DodoZimmermann/lamp-2/Hardware/Electrical/PCB_v2/Images/JLCPCB stackup and trace width.jpg

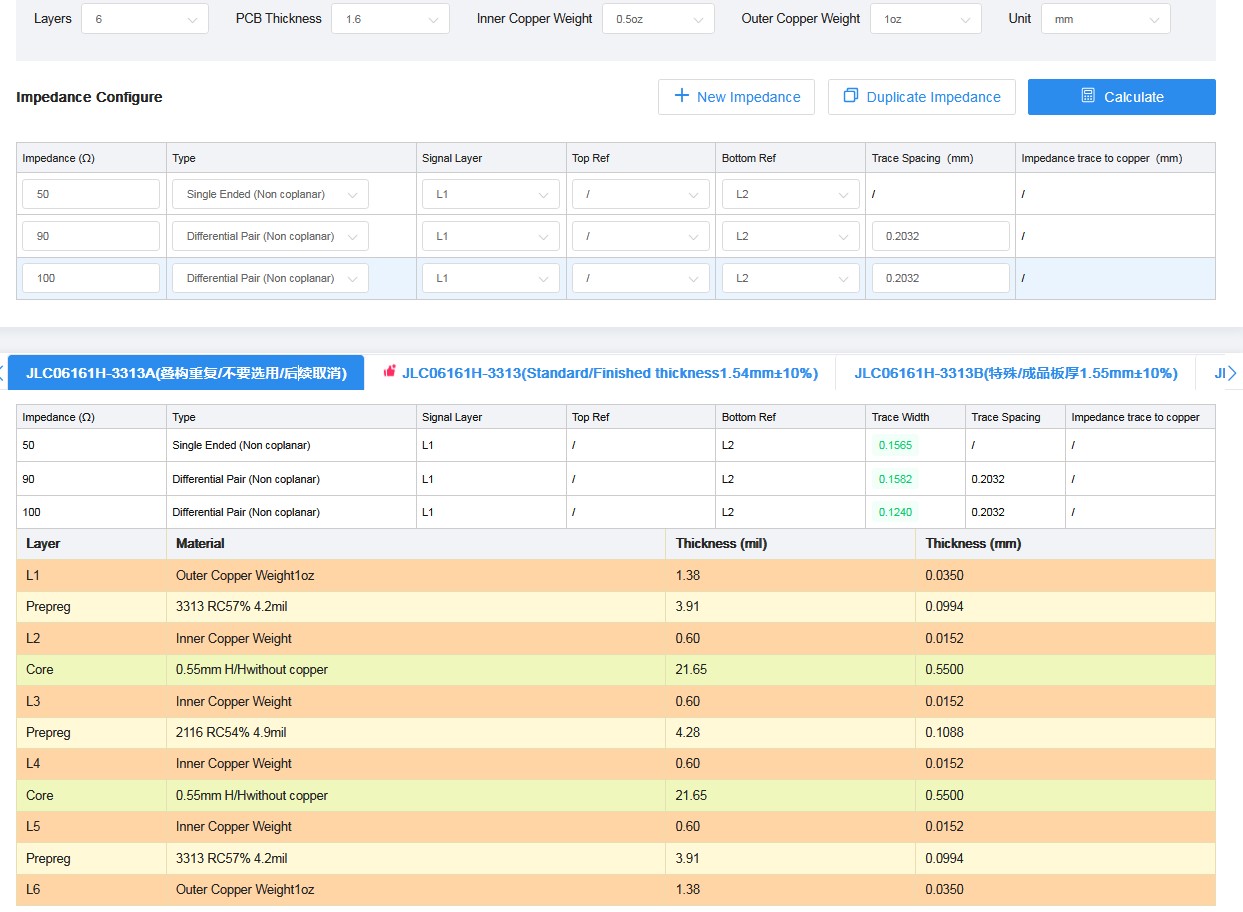
Hardware/Electrical/PCB_v2/Images/JLCPCB stackup and trace width.jpg
