DodoZimmermann/lamp-2/Hardware/Electrical/PCB_v2/Images/LED_Grid.png

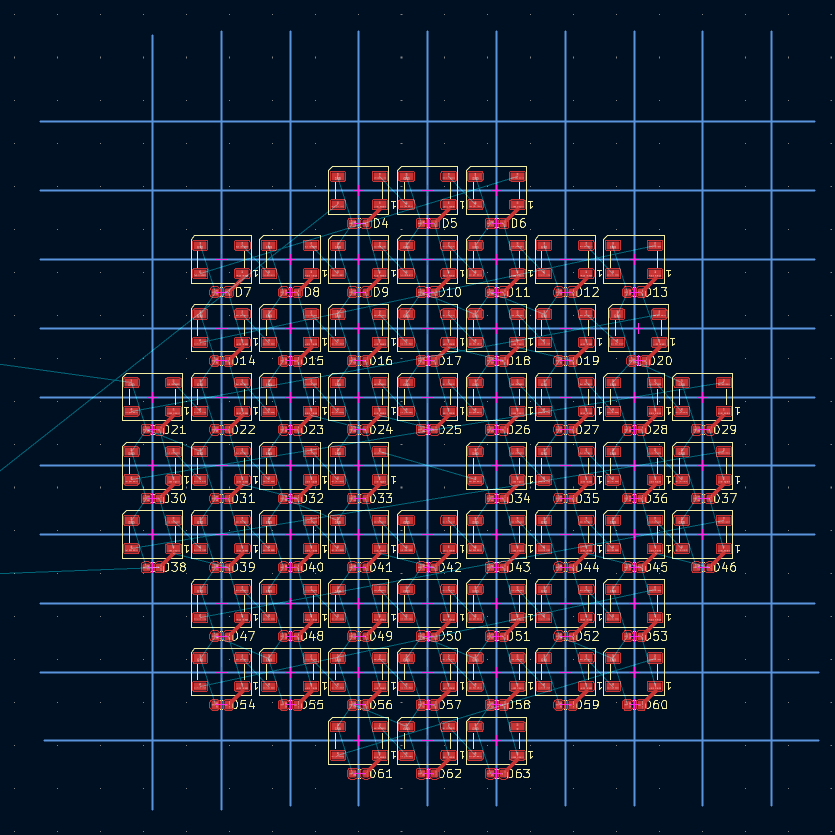
Hardware/Electrical/PCB_v2/Images/LED_Grid.png
