DodoZimmermann/lamp-2/Hardware/Electrical/Parts List.xlsx

Description | Supplier | Supplier Part Nr | Manufacturer | Manufacturer Part Nr | Price | Amount | Total price
Li-ion Cell 18650 3300mAh | Conrad | 1558872 - 62 | Panasonic | NCR18650GA | CHF 4.95 | 4 | CHF 19.80
