DodoZimmermann/lamp-2/Hardware/Electrical/PCB_Outline.dxf

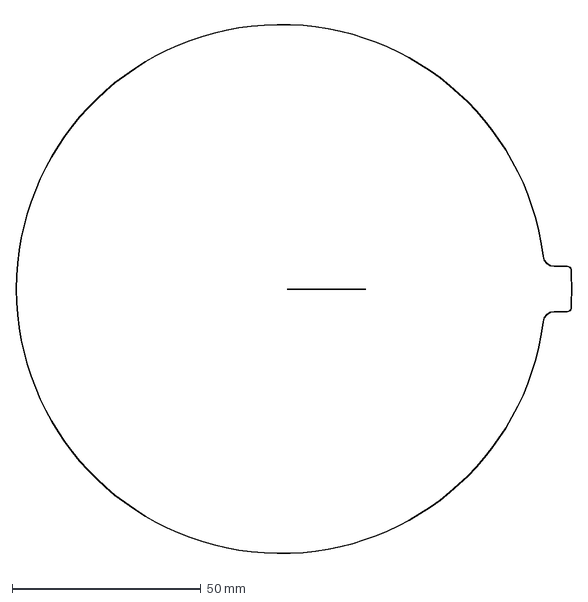
[picture p3: CAD file, 2026-04-02]
Hardware/Electrical/PCB_Outline.dxf
147.0 x 144.3 mm
