DodoZimmermann/lamp-2/Hardware/Electrical/PCB_v2/lamp_PCBv2.step

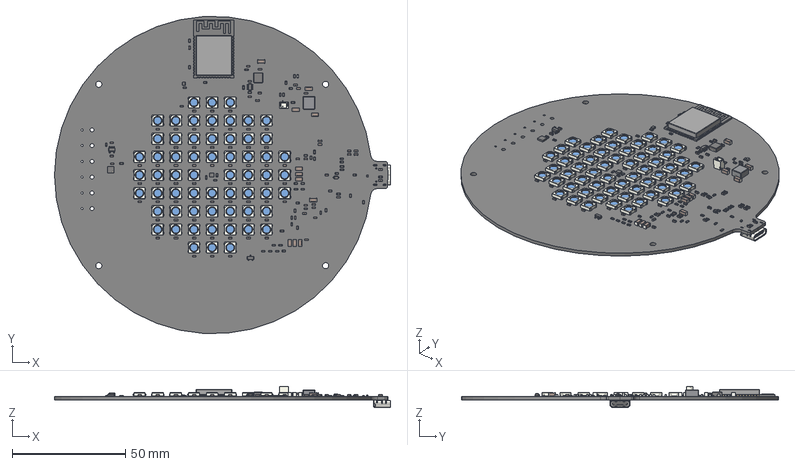
[picture p4: CAD file, 2026-06-07]
Hardware/Electrical/PCB_v2/lamp_PCBv2.step
148.2 x 139.7 x 9.27 mm
C_0603_1608Metric x 93
R_0603_1608Metric x 52
C_1206_3216Metric x 11
LED_WS2812B_PLCC4_5.0x5.0mm_P3.2mm x 60
WSON-8-1EP_2x2mm_P0.5mm_EP0.9x1.6mm
SOT-23
SOT-563
SOT-23-6
SOT-23-5
DFN-10-1EP_3x3mm_P0.5mm_EP1.55x2.48mm
Texas_DRT-3
LED_0603_1608Metric
ESP32-S3-WROOM-1
L_Bourns_SRP5030T
D_SOD-323
L_Pulse_PA5402
JST_SH_BM02B-SRSS-TB_1x02-1MP_P1.00mm_Vertical
USB_C_Receptacle_GCT_USB4105-xx-A_16P_TopMnt_Horizontal
PCB_v2_PCB_1
PCB_v2_PCB_2
