DodoZimmermann/lamp-2/Hardware/Mechanical/LampBall_Gross.step

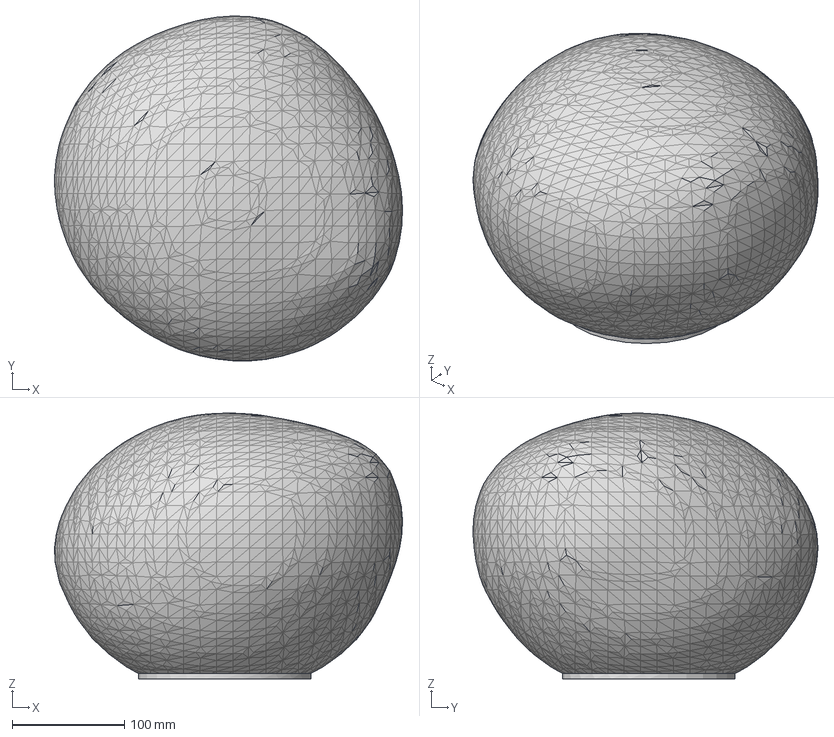
[picture p5: CAD file, 2026-04-02]
Hardware/Mechanical/LampBall_Gross.step
310.6 x 307.8 x 237.2 mm
