DodoZimmermann/lamp-2/Hardware/Mechanical/LampBall.stl

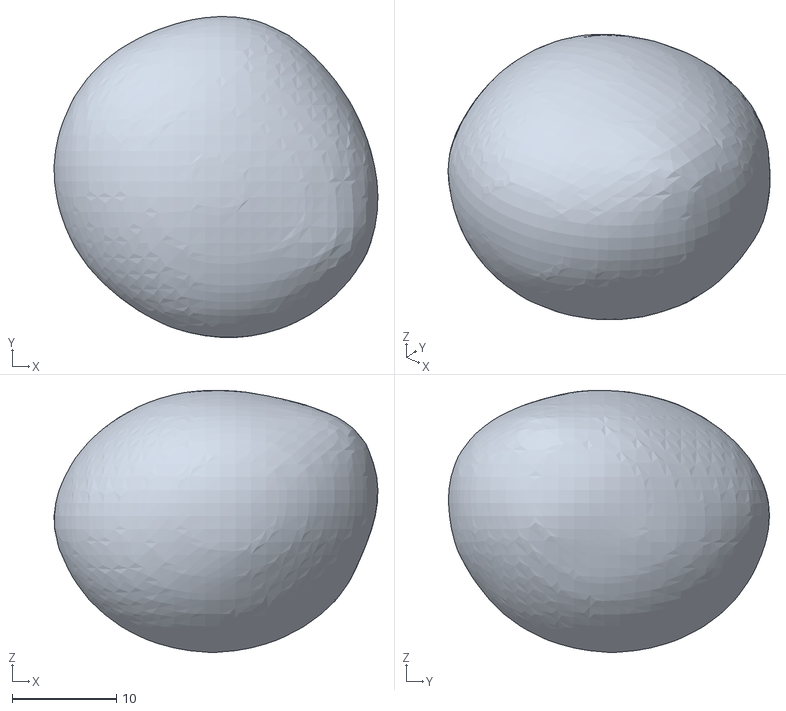
[picture p6: CAD file, 2026-04-02]
Hardware/Mechanical/LampBall.stl
31.1 x 30.8 x 25.2
