DodoZimmermann/lamp-2/Hardware/Electrical/PCB/Extra-devices/BQ24600RVAR/BQ24600RVAR.step

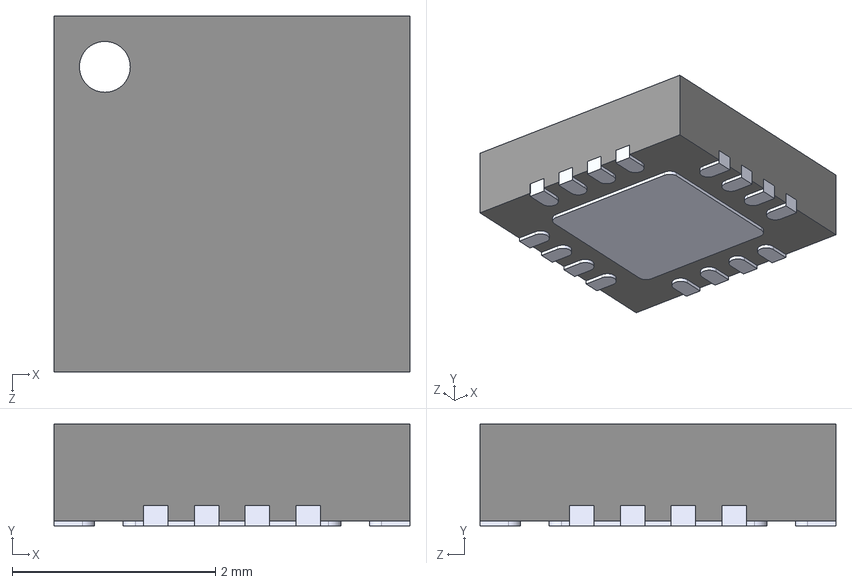
[picture p7: CAD file, 2026-03-09, an earlier design]
Hardware/Electrical/PCB/Extra-devices/BQ24600RVAR/BQ24600RVAR.step
3.50 x 1.00 x 3.50 mm
