DodoZimmermann/lamp-2/(list of files, cad)

Other CAD files:
Hardware/Mechanical/LampBall.blend
Hardware/Mechanical/LampBall.f3d
