DodoZimmermann/lamp-2/Hardware/Electrical/PCB_v2/PCB_v2.kicad_pcb

## KiCad design Hardware/Electrical/PCB_v2/PCB_v2.kicad_pcb (2026-06-07)

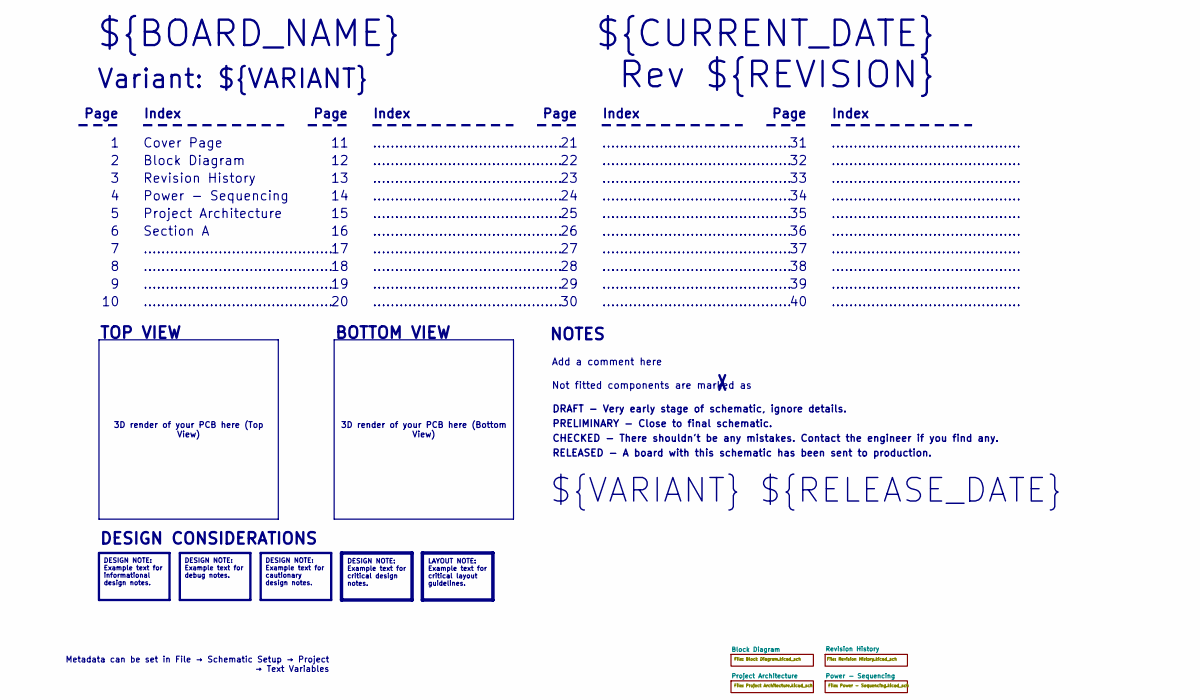
[picture p8: schematic PCB_v2.kicad_sch, Cover Page]

Notes on the sheet:
BOTTOM VIEW
...........................................
RELEASED - A board with this schematic has been sent to production.
Page
TOP VIEW
Not fitted components are marked as
Index
PRELIMINARY - Close to final schematic.
${VARIANT} ${RELEASE_DATE}
Power - Sequencing
${CURRENT_DATE}
Variant: ${VARIANT}
Rev ${REVISION}
Project Architecture
${BOARD_NAME}
DRAFT - Very early stage of schematic, ignore details.
Section A
Block Diagram
Add a comment here
Cover Page
NOTES
Revision History
CHECKED - There shouldn't be any mistakes. Contact the engineer if you find any.
DESIGN CONSIDERATIONS
3D render of your PCB here (Bottom View)
3D render of your PCB here (Top View)
Metadata can be set in File → Schematic Setup → Project → Text Variables
DESIGN NOTE: Example text for informational design notes.
LAYOUT NOTE: Example text for critical layout guidelines.
DESIGN NOTE: Example text for cautionary design notes.
DESIGN NOTE: Example text for debug notes.
DESIGN NOTE: Example text for critical design notes.

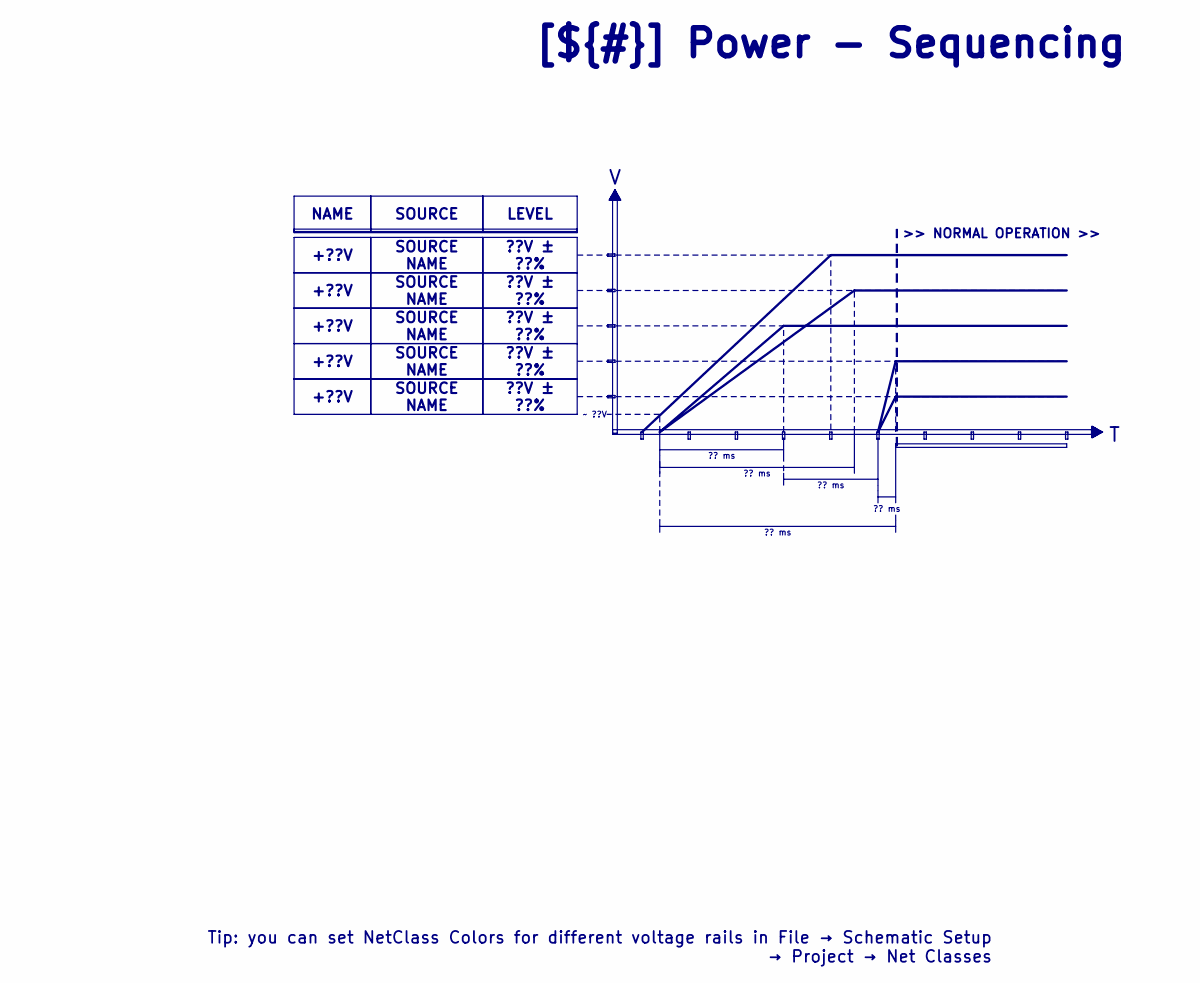
[picture p9: schematic Power - Sequencing.kicad_sch]

Notes on the sheet:
>> NORMAL OPERATION >>
LEVEL
+??V
SOURCE NAME
?? ms
??V ± ??%
[${#}] ${TITLE}
~ ??V
NAME
SOURCE
Tip: you can set NetClass Colors for different voltage rails in File → Schematic Setup → Project → Net Classes

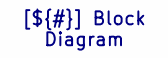
[picture p10: schematic Block Diagram.kicad_sch]

Notes on the sheet:
[${#}] ${TITLE}


Notes on the sheet:
- _________________________________ - _________________________________ - _________________________________ - _________________________________ - _________________________________ - _________________________________ - _________________________________ - _________________________________ - _________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
DD.MM.YYYY - xxx Revision Variant: xxx
[${#}] ${TITLE}

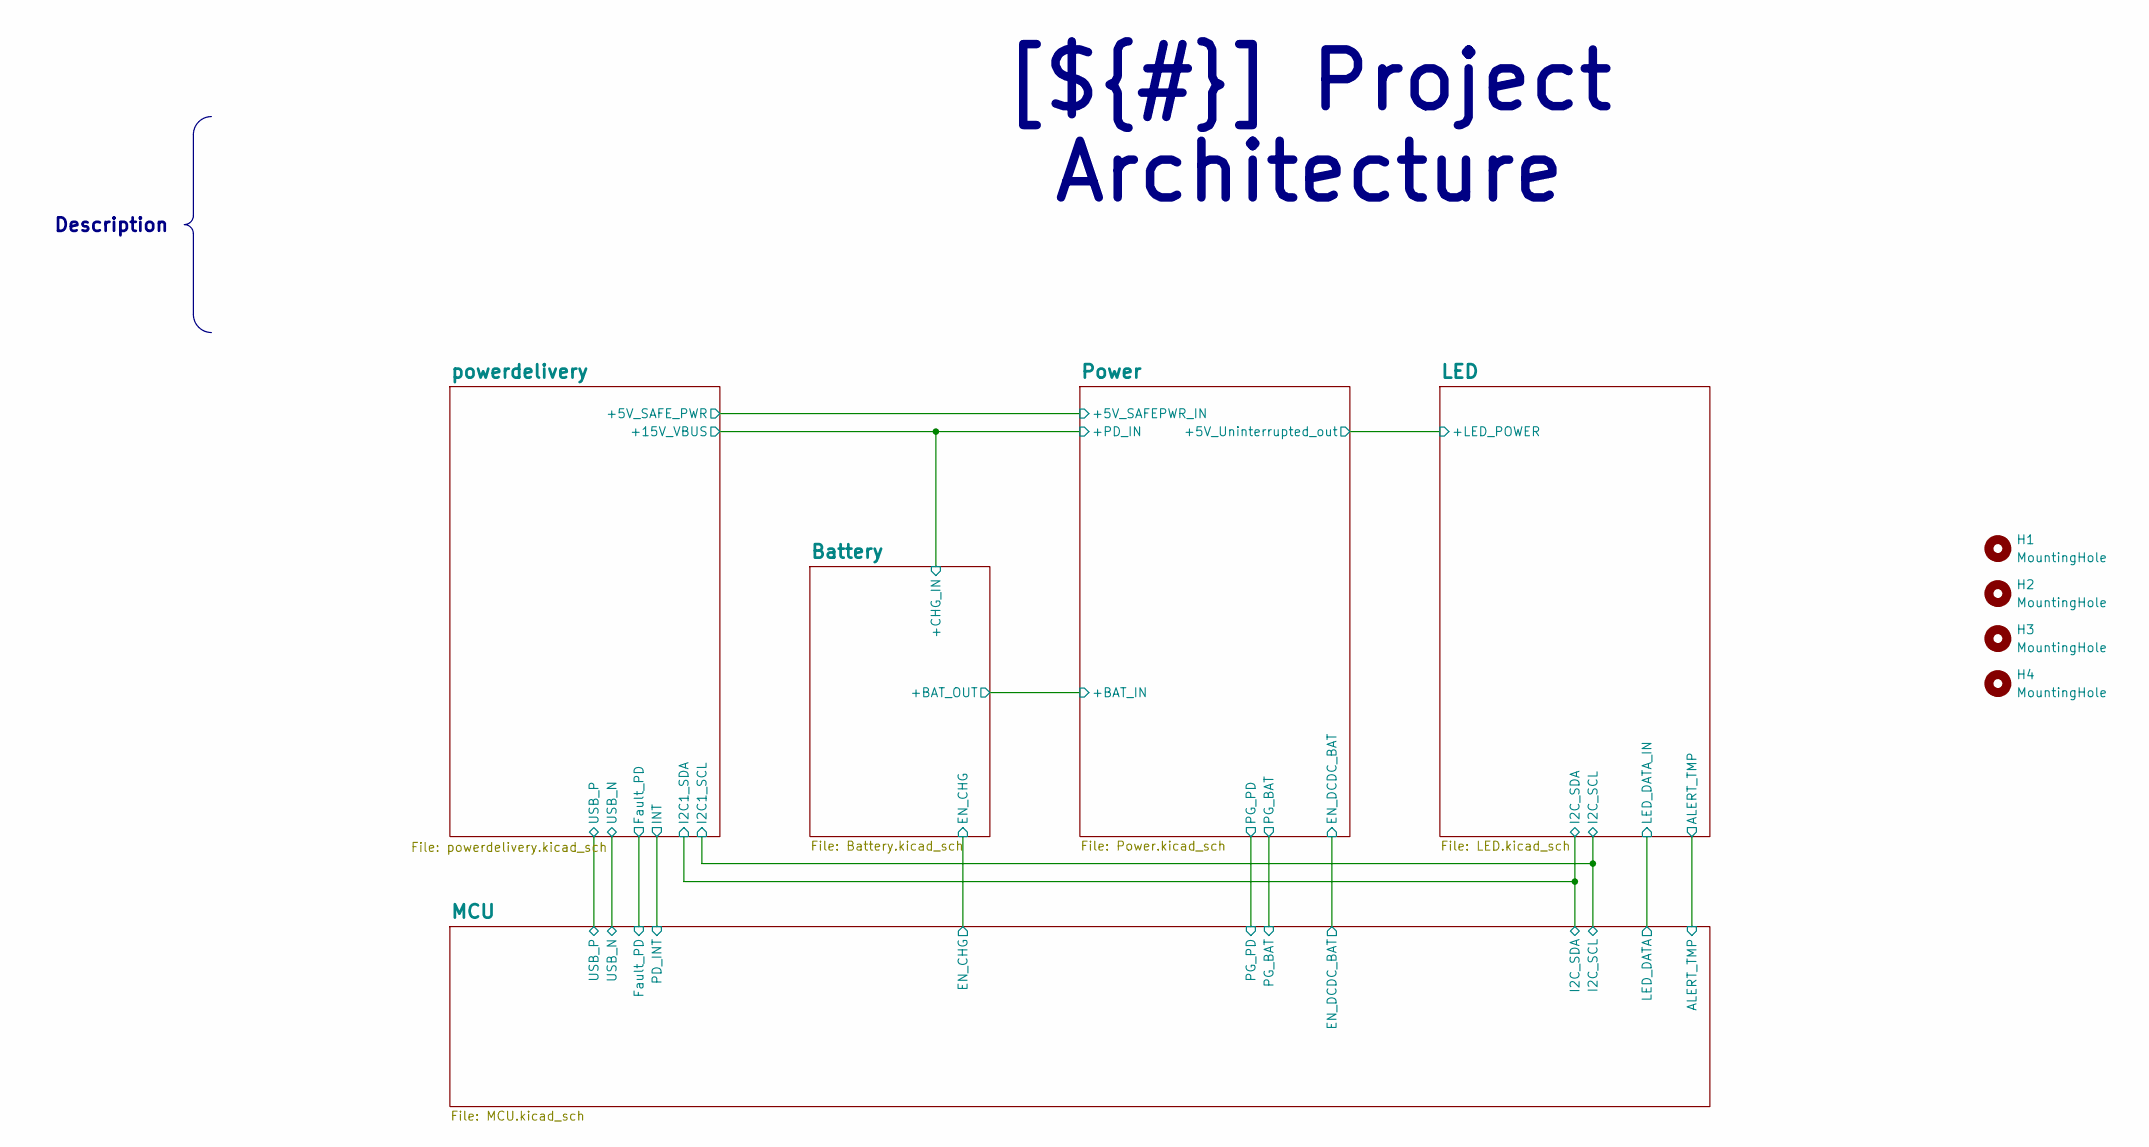
[picture p12: schematic Project Architecture.kicad_sch]

Parts:
H1, H2, H3, H4: MountingHole; MountingHole_2.7mm_M2.5

Notes on the sheet:
Description
[${#}] ${TITLE}

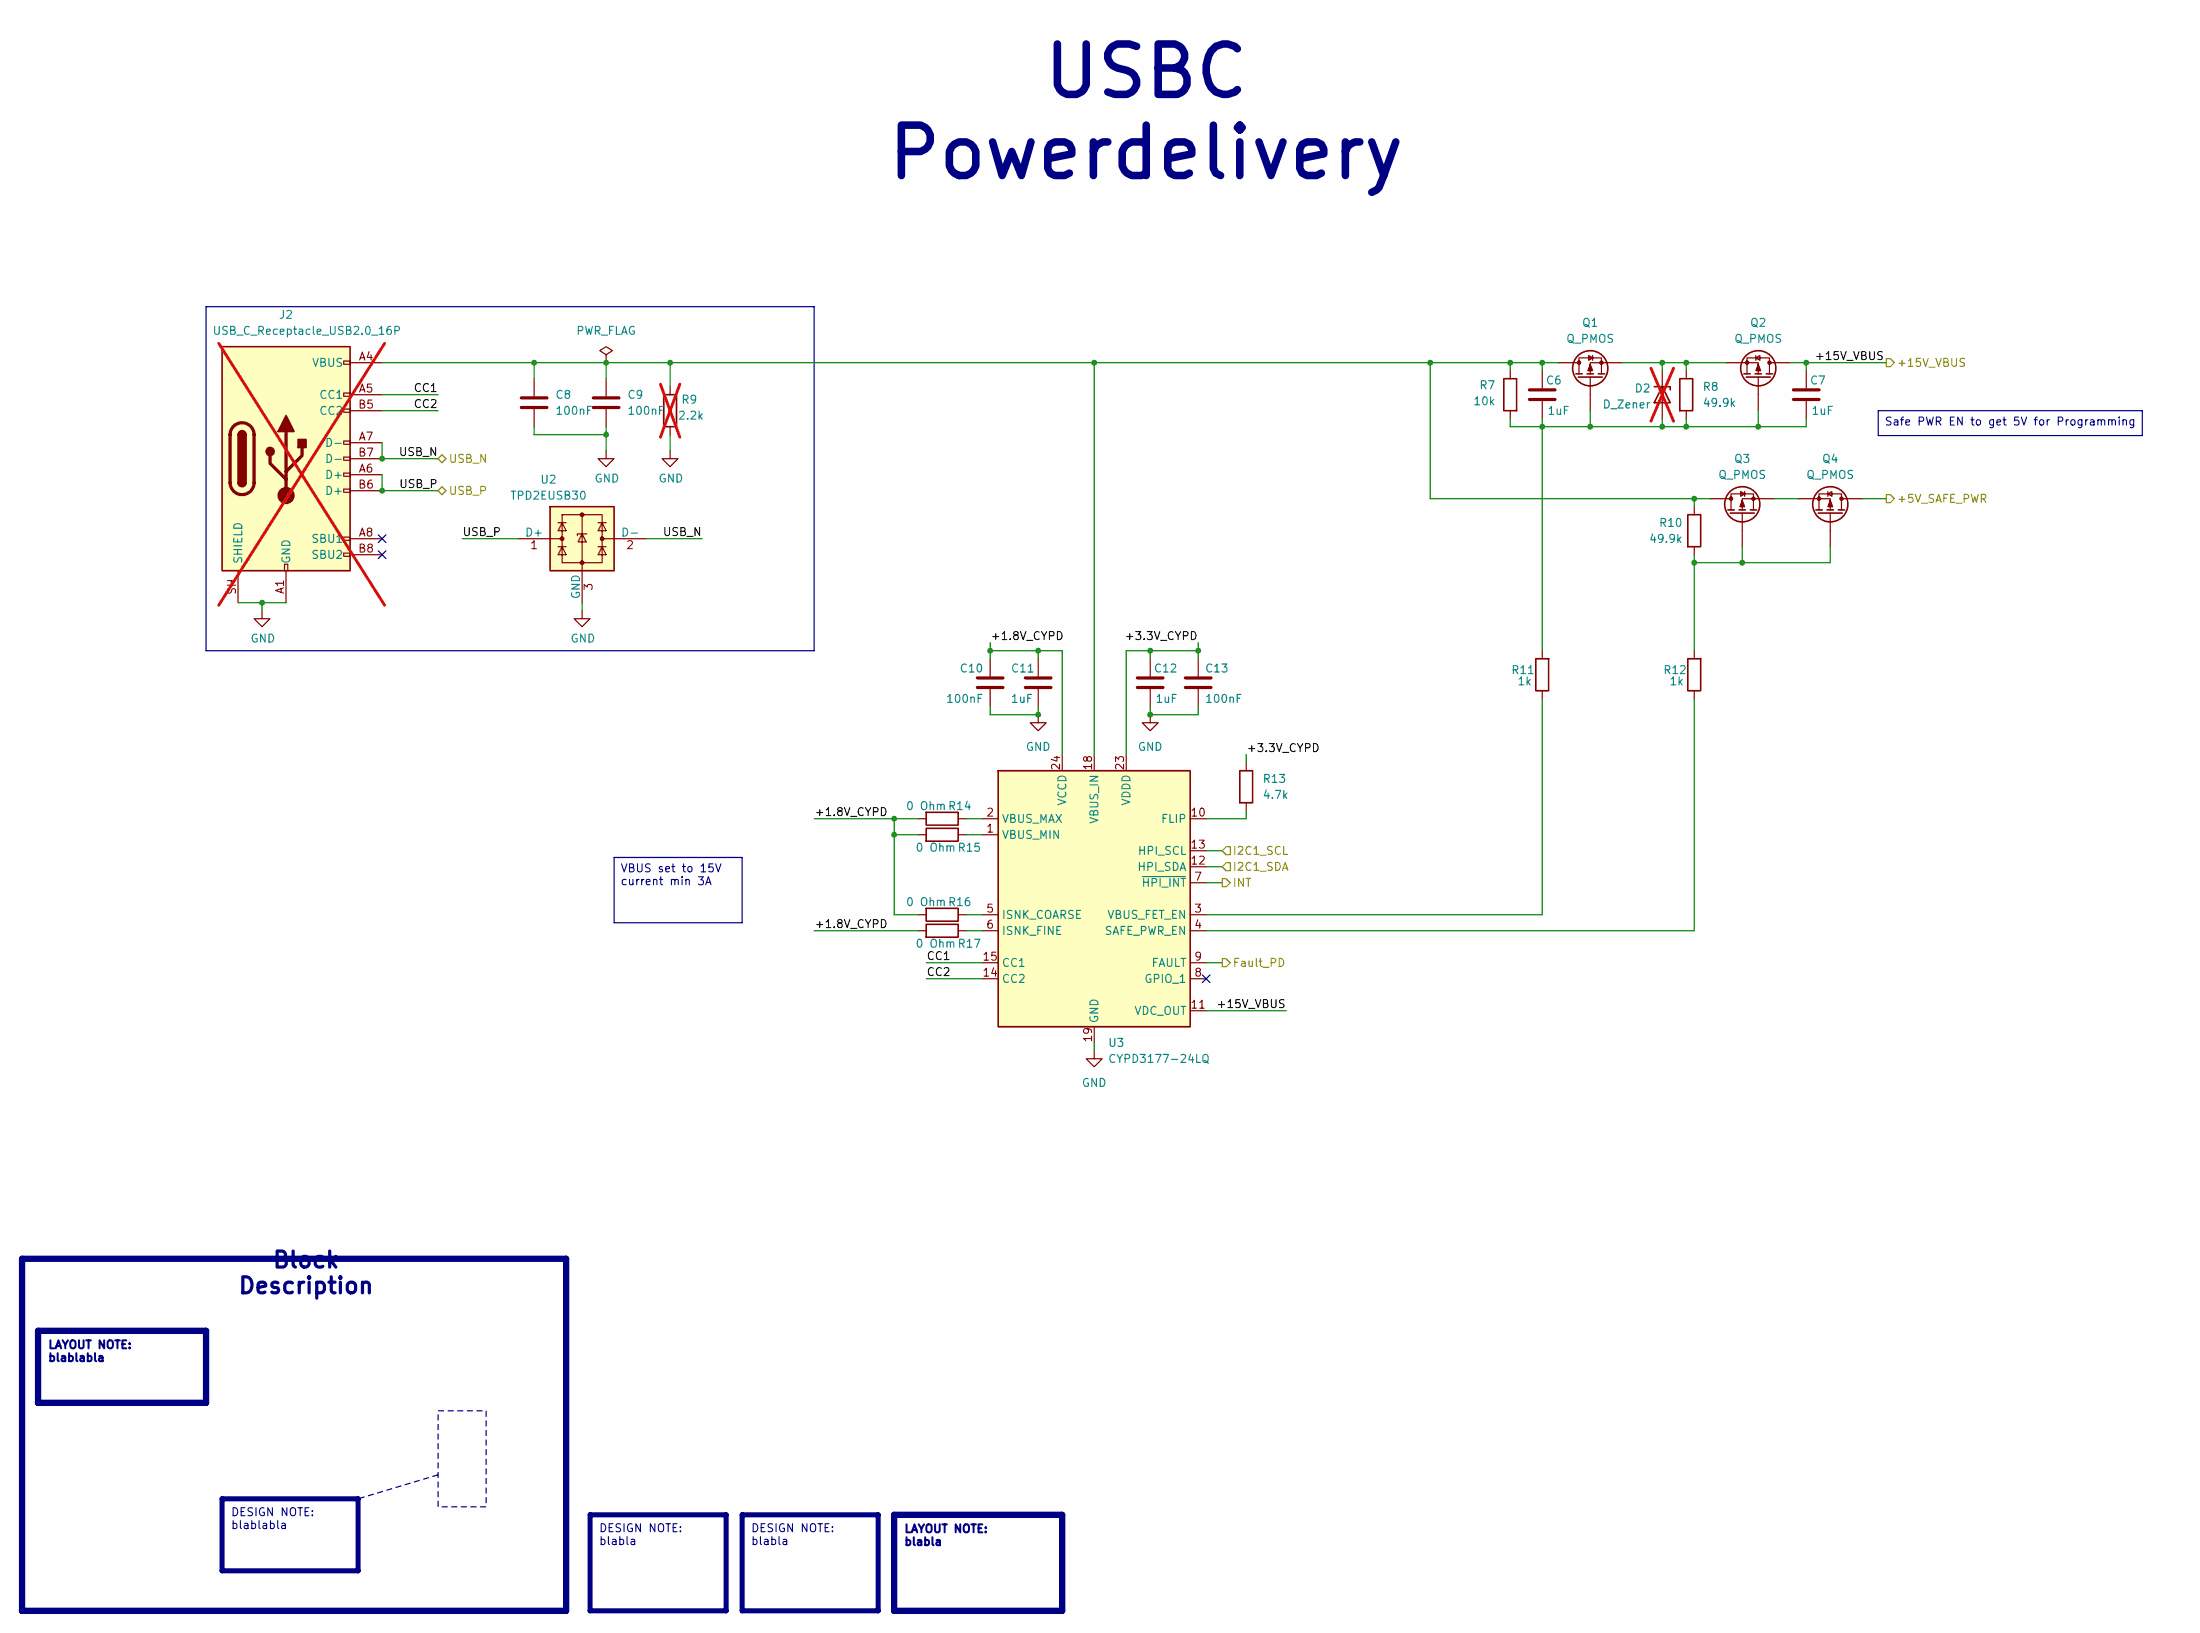
[picture p13: schematic powerdelivery.kicad_sch, Sheet Title A]

Parts:
C6, C7, C11, C12: 1uF; C_0603_1608Metric; Manufacturer Part Number CC0603KRX7R9BB105; LCSC Part # C15849
C8, C9, C10, C13: 100nF; C_0603_1608Metric; Manufacturer Part Number 885012206095; LCSC Part # C14663
D2: D_Zener; D_SOD-323; not fitted
J2: USB_C_Receptacle_USB2.0_16P; USB_C_Receptacle_GCT_USB4105-xx-A_16P_TopMnt_Horizontal; Manufacturer Part Number USB4105-GF-A; not fitted
Q1, Q2, Q3, Q4: Q_PMOS; PowerPAK_SO-8; Manufacturer Part Number SI7149ADP-T1-GE3; LCSC Part # C554002
R7: 10k; R_0603_1608Metric; Manufacturer Part Number ERJ-PB3B1002V; LCSC Part # C25804
R8, R10: 49.9k; R_0603_1608Metric; LCSC Part # C23184
R9: 2.2k; R_0603_1608Metric; Manufacturer Part Number RC0603FR-072K2L; LCSC Part # C114662; not fitted
R11, R12: 1k; R_0603_1608Metric; Manufacturer Part Number RC0603FR-071KL; LCSC Part # C21190
R13: 4.7k; R_0603_1608Metric; LCSC Part # C23162
R14, R15, R16, R17: 0 Ohm; R_0603_1608Metric; Manufacturer Part Number RC0603JR-070RL; LCSC Part # C21189
U2: TPD2EUSB30; Texas_DRT-3; Manufacturer Part Number TPD2EUSB30ADRTR; LCSC Part # C97502
U3: CYPD3177-24LQ; QFN-24-1EP_4x4mm_P0.5mm_EP2.75x2.75mm; LCSC Part # C2959321

Connections:
/Project Architecture/LED/I2C_SCL: U3.13 (HPI_SCL); also elsewhere on the board
/Project Architecture/LED/I2C_SDA: U3.12 (HPI_SDA); also elsewhere on the board
/Project Architecture/MCU/Fault_PD: U3.9 (FAULT); also elsewhere on the board
/Project Architecture/MCU/PD_INT: U3.7 (~HPI_INT); also elsewhere on the board
/Project Architecture/Power/+5V_SAFEPWR_IN: Q4.D; also elsewhere on the board
/Project Architecture/powerdelivery/+1.8V_CYPD: C10.2, C11.2, R14.2, R15.2, R16.2, R17.2, U3.24 (VCCD)
/Project Architecture/powerdelivery/+3.3V_CYPD: C12.2, C13.2, R13.1, U3.23 (VDDD)
/Project Architecture/powerdelivery/+15V_VBUS: C7.2, Q2.D, U3.11 (VDC_OUT); also elsewhere on the board
/Project Architecture/powerdelivery/CC1: J2.A5 (CC1), U3.15 (CC1)
/Project Architecture/powerdelivery/CC2: J2.B5 (CC2), U3.14 (CC2)
/Project Architecture/powerdelivery/USB_N: J2.A7 (D-), J2.B7 (D-), U2.2 (D-); also elsewhere on the board
/Project Architecture/powerdelivery/USB_P: J2.A6 (D+), J2.B6 (D+), U2.1 (D+); also elsewhere on the board
GND: C8.1, C9.1, C10.1, C11.1, C12.1, C13.1, J2.A1 (GND), J2.A12 (GND), J2.B1 (GND), J2.B12 (GND), J2.SH (SHIELD), R9.1, U2.3 (GND), U3.19 (GND), U3.22 (GND), U3.25 (GND); also elsewhere on the board
unnamed: C6.1, C7.1, D2.2 (A), Q1.G, Q2.G, R7.2, R8.2, R11.2
unnamed: D2.1 (K), Q1.S, Q2.S, R8.1
unnamed: Q3.G, Q4.G, R10.2, R12.2
unnamed: Q3.S, Q4.S
unnamed: R13.2, U3.10 (FLIP)
unnamed: R16.1, U3.5 (ISNK_COARSE)
unnamed: R17.1, U3.6 (ISNK_FINE)
unnamed: R12.1, U3.4 (SAFE_PWR_EN)
unnamed: R11.1, U3.3 (VBUS_FET_EN)
unnamed: C6.2, C8.2, C9.2, J2.A4 (VBUS), J2.A9 (VBUS), J2.B4 (VBUS), J2.B9 (VBUS), Q1.D, Q3.D, R7.1, R9.2, R10.1, U3.18 (VBUS_IN)
unnamed: R14.1, U3.2 (VBUS_MAX)
unnamed: R15.1, U3.1 (VBUS_MIN)

Notes on the sheet:
Block Description
DESIGN NOTE: blabla
LAYOUT NOTE: blablabla
USBC Powerdelivery
LAYOUT NOTE: blabla
Safe PWR EN to get 5V for Programming
DESIGN NOTE: blablabla
VBUS set to 15V current min 3A

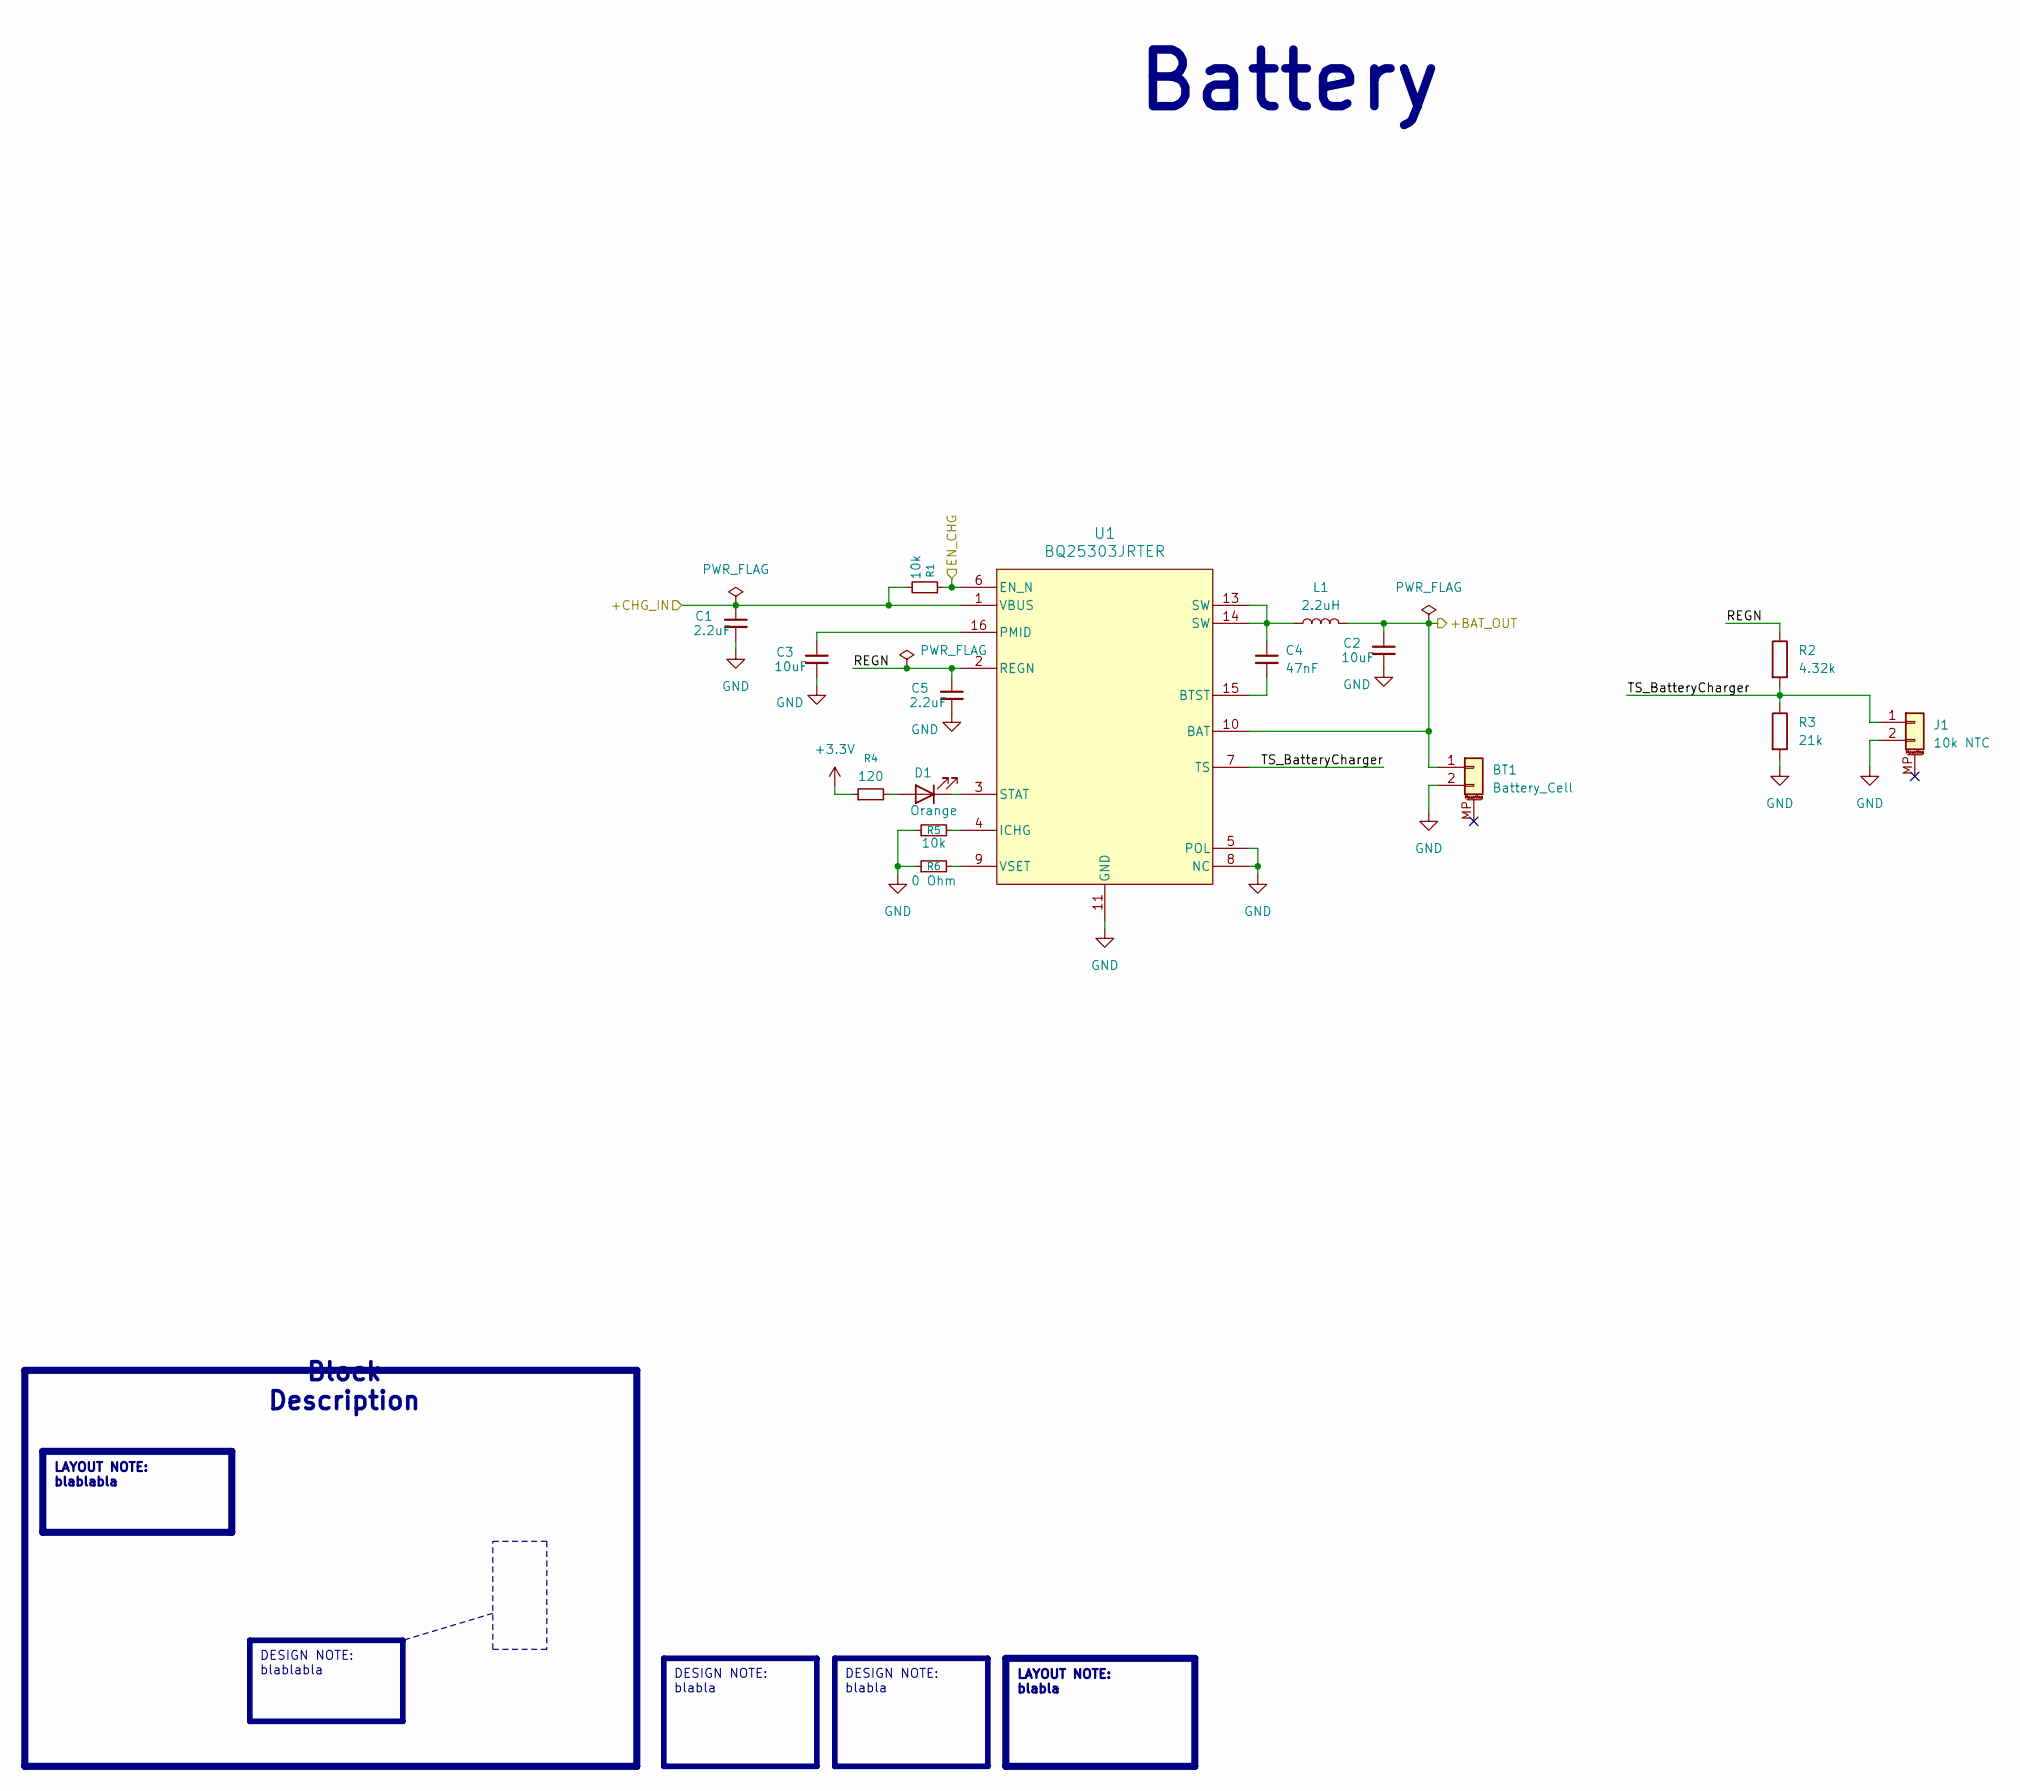
[picture p14: schematic Battery.kicad_sch, Sheet Title A]

Parts:
BT1: Battery_Cell; Molex_Micro-Fit_3.0_43650-0224_1x02-1MP_P3.00mm_Vertical; LCSC Part # C122425
C1, C5: 2.2uF; C_0603_1608Metric; LCSC Part # C23630
C2, C3: 10uF; C_1206_3216Metric; LCSC Part # C13585
C4: 47nF; C_0603_1608Metric; LCSC Part # C1622
D1: Orange; LED_0603_1608Metric; LCSC Part # C2286
J1: 10k NTC; JST_SH_BM02B-SRSS-TB_1x02-1MP_P1.00mm_Vertical; LCSC Part # C160388
L1: 2.2uH; L_Bourns_SRP5030T; LCSC Part # C2847475
R1, R5: 10k; R_0603_1608Metric; LCSC Part # C25804
R2: 4.32k; R_0603_1608Metric; LCSC Part # C23158
R3: 21k; R_0603_1608Metric; LCSC Part # C137769
R4: 120; R_0603_1608Metric; LCSC Part # C22765
R6: 0 Ohm; R_0603_1608Metric; LCSC Part # C21189
U1: BQ25303JRTER; WQFN-16-1EP_3x3mm_P0.5mm_EP1.68x1.68mm; LCSC Part # C2842775

Connections:
+3.3V: R4.1; also elsewhere on the board
/Project Architecture/Battery/+BAT_OUT: BT1.1, C2.1, L1.2, U1.10 (BAT); also elsewhere on the board
/Project Architecture/Battery/EN_CHG: R1.1, U1.6 (EN_N); also elsewhere on the board
/Project Architecture/Battery/REGN: C5.1, R2.1, U1.2 (REGN)
/Project Architecture/Battery/TS_BatteryCharger: J1.1, R2.2, R3.1, U1.7 (TS)
/Project Architecture/powerdelivery/+15V_VBUS: C1.1, R1.2, U1.1 (VBUS); also elsewhere on the board
GND: BT1.2, C1.2, C2.2, C3.2, C5.2, J1.2, R3.2, R5.1, R6.1, U1.5 (POL), U1.8 (NC), U1.11 (GND), U1.12 (GND), U1.17 (PAD); also elsewhere on the board
unnamed: C4.1, L1.1, U1.13 (SW), U1.14 (SW)
unnamed: D1.2 (A), R4.2
unnamed: D1.1 (K), U1.3 (STAT)
unnamed: C4.2, U1.15 (BTST)
unnamed: R5.2, U1.4 (ICHG)
unnamed: C3.1, U1.16 (PMID)
unnamed: R6.2, U1.9 (VSET)

Notes on the sheet:
Battery
LAYOUT NOTE: blablabla
DESIGN NOTE: blabla
Block Description
LAYOUT NOTE: blabla
DESIGN NOTE: blablabla

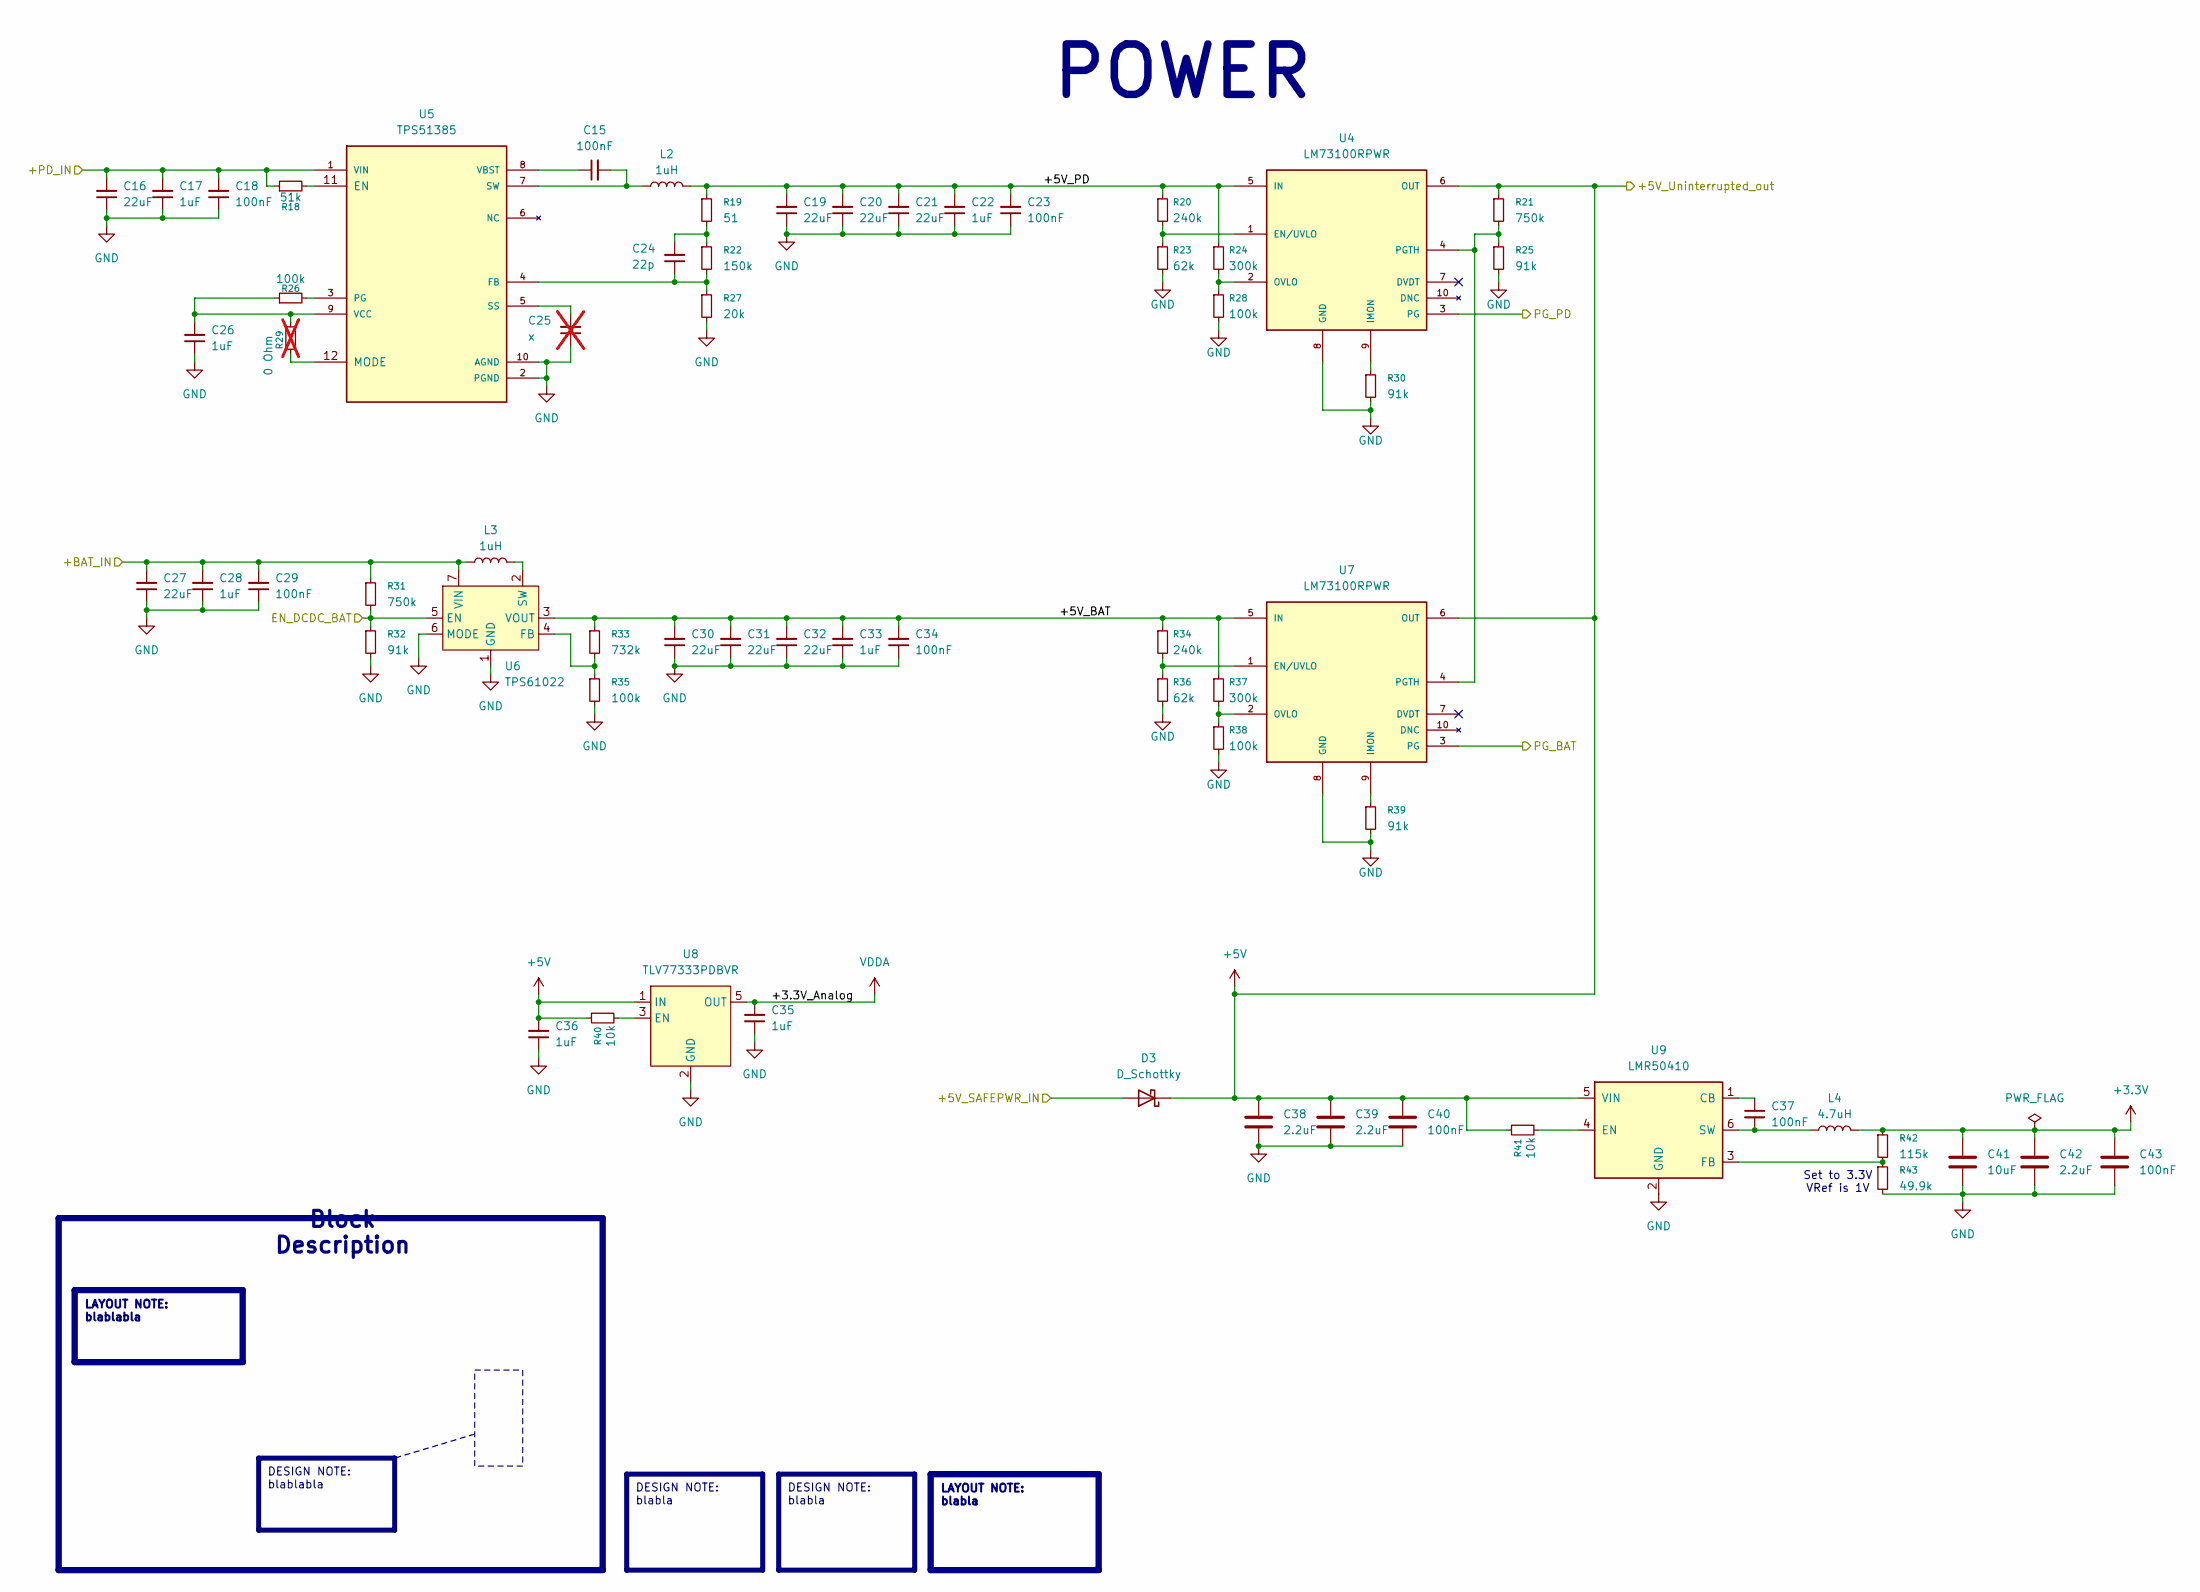
[picture p15: schematic Power.kicad_sch, Sheet Title A]

Parts:
C15, C18, C23, C29, C34, C37, C40, C43: 100nF; C_0603_1608Metric; LCSC Part # C14663
C16, C19, C20, C21, C27, C30, C31, C32: 22uF; C_1206_3216Metric; LCSC Part # C12891
C17, C22, C26, C28, C33, C35, C36: 1uF; C_0603_1608Metric; LCSC Part # C15849
C24: 22p; C_0603_1608Metric; LCSC Part # C1653
C25: x; C_0603_1608Metric; not fitted
C38, C39, C42: 2.2uF; C_0603_1608Metric; LCSC Part # C23630
C41: 10uF; C_1206_3216Metric; LCSC Part # C13585
D3: D_Schottky; SOT-23; LCSC Part # C2135
L2, L3: 1uH; L_Bourns_SRP7028A_7.3x6.6mm; LCSC Part # C2847480
L4: 4.7uH; L_Pulse_PA5402; LCSC Part # C553980
R18: 51k; R_0603_1608Metric; LCSC Part # C23196
R19: 51; R_0603_1608Metric; LCSC Part # C23197
R20, R34: 240k; R_0603_1608Metric; LCSC Part # C137765
R21, R31: 750k; R_0603_1608Metric; LCSC Part # C137684
R22: 150k; R_0603_1608Metric; LCSC Part # C22807
R23, R36: 62k; R_0603_1608Metric; LCSC Part # C137694
R24, R37: 300k; R_0603_1608Metric; LCSC Part # C23024
R25, R30, R32, R39: 91k; R_0603_1608Metric; LCSC Part # C23265
R26, R28, R35, R38: 100k; R_0603_1608Metric; LCSC Part # C25803
R27: 20k; R_0603_1608Metric; LCSC Part # C4184
R29: 0 Ohm; R_0603_1608Metric; not fitted
R33: 732k; R_0603_1608Metric; LCSC Part # C246003
R40, R41: 10k; R_0603_1608Metric; LCSC Part # C25804
R42: 115k; R_0603_1608Metric; LCSC Part # C22783
R43: 49.9k; R_0603_1608Metric; LCSC Part # C23184
U4, U7: LM73100RPWR; IC_LM73100RPWR; PARTREV 08/2019; LCSC Part # C3210761
U5: TPS51385; VREG_TPS51386RJNR; LCSC Part # C22418767
U6: TPS61022; Texas_RWU0007A_VQFN-7_2x2mm_P0.5mm; LCSC Part # C915088
U8: TLV77333PDBVR; SOT-23-5; LCSC C32445874
U9: LMR50410; SOT-23-6; LCSC Part # C2841056

Connections:
+3.3V: C41.1, C42.1, C43.1, L4.2, R42.1; also elsewhere on the board
+5V: C36.2, C38.1, C39.1, C40.1, D3.3 (K), R21.1, R40.1, R41.1, U4.6 (OUT), U7.6 (OUT), U8.1 (IN), U9.5 (VIN); also elsewhere on the board
/Project Architecture/Battery/+BAT_OUT: C27.2, C28.2, C29.2, L3.1, R31.1, U6.7 (VIN); also elsewhere on the board
/Project Architecture/MCU/EN_DCDC_BAT: R31.2, R32.1, U6.5 (EN); also elsewhere on the board
/Project Architecture/MCU/PG_BAT: U7.3 (PG); also elsewhere on the board
/Project Architecture/MCU/PG_PD: U4.3 (PG); also elsewhere on the board
/Project Architecture/Power/+5V_BAT: C30.2, C31.2, C32.2, C33.2, C34.2, R33.1, R34.1, R37.1, U6.3 (VOUT), U7.5 (IN)
/Project Architecture/Power/+5V_PD: C19.2, C20.2, C21.2, C22.2, C23.2, L2.2, R19.1, R20.1, R24.1, U4.5 (IN)
/Project Architecture/Power/+5V_SAFEPWR_IN: D3.1 (A), D3.2 (A); also elsewhere on the board
/Project Architecture/powerdelivery/+15V_VBUS: C16.2, C17.2, C18.2, R18.1, U5.1 (VIN); also elsewhere on the board
GND: C16.1, C17.1, C18.1, C19.1, C20.1, C21.1, C22.1, C23.1, C25.1, C26.1, C27.1, C28.1, C29.1, C30.1, C31.1, C32.1, C33.1, C34.1, C35.1, C36.1, C38.2, C39.2, C40.2, C41.2, C42.2, C43.2, R23.2, R25.2, R27.2, R28.2, R30.2, R32.2, R35.2, R36.2, R38.2, R39.2, R43.2, U4.8 (GND), U5.2 (PGND), U5.10 (AGND), U6.1 (GND), U6.6 (MODE), U7.8 (GND), U8.2 (GND), U8.4 (NC), U9.2 (GND); also elsewhere on the board
unnamed: C24.2, R19.2, R22.1
unnamed: R20.2, R23.1, U4.1 (EN/UVLO)
unnamed: R30.1, U4.9 (IMON)
unnamed: R24.2, R28.1, U4.2 (OVLO)
unnamed: R21.2, R25.1, U4.4 (PGTH), U7.4 (PGTH)
unnamed: R18.2, U5.11 (EN)
unnamed: C24.1, R22.2, R27.1, U5.4 (FB)
unnamed: R29.1, U5.12 (MODE)
unnamed: R26.2, U5.3 (PG)
unnamed: C25.2, U5.5 (SS)
unnamed: C15.2, L2.1, U5.7 (SW)
unnamed: C15.1, U5.8 (VBST)
unnamed: C26.2, R26.1, R29.2, U5.9 (VCC)
unnamed: R33.2, R35.1, U6.4 (FB)
unnamed: L3.2, U6.2 (SW)
unnamed: R34.2, R36.1, U7.1 (EN/UVLO)
unnamed: R39.1, U7.9 (IMON)
unnamed: R37.2, R38.1, U7.2 (OVLO)
unnamed: R40.2, U8.3 (EN)
unnamed: C37.1, U9.1 (CB)
unnamed: R41.2, U9.4 (EN)
unnamed: R42.2, R43.1, U9.3 (FB)
unnamed: C37.2, L4.1, U9.6 (SW)
VDDA: C35.2, U8.5 (OUT); also elsewhere on the board

Notes on the sheet:
Set to 3.3V VRef is 1V
LAYOUT NOTE: blabla
POWER
DESIGN NOTE: blabla
DESIGN NOTE: blablabla
LAYOUT NOTE: blablabla
Block Description
