DodoZimmermann/lamp-2/Hardware/Electrical/PCB_v2/PCB_v2.kicad_pcb

## KiCad design Hardware/Electrical/PCB_v2/PCB_v2.kicad_pcb (continued)

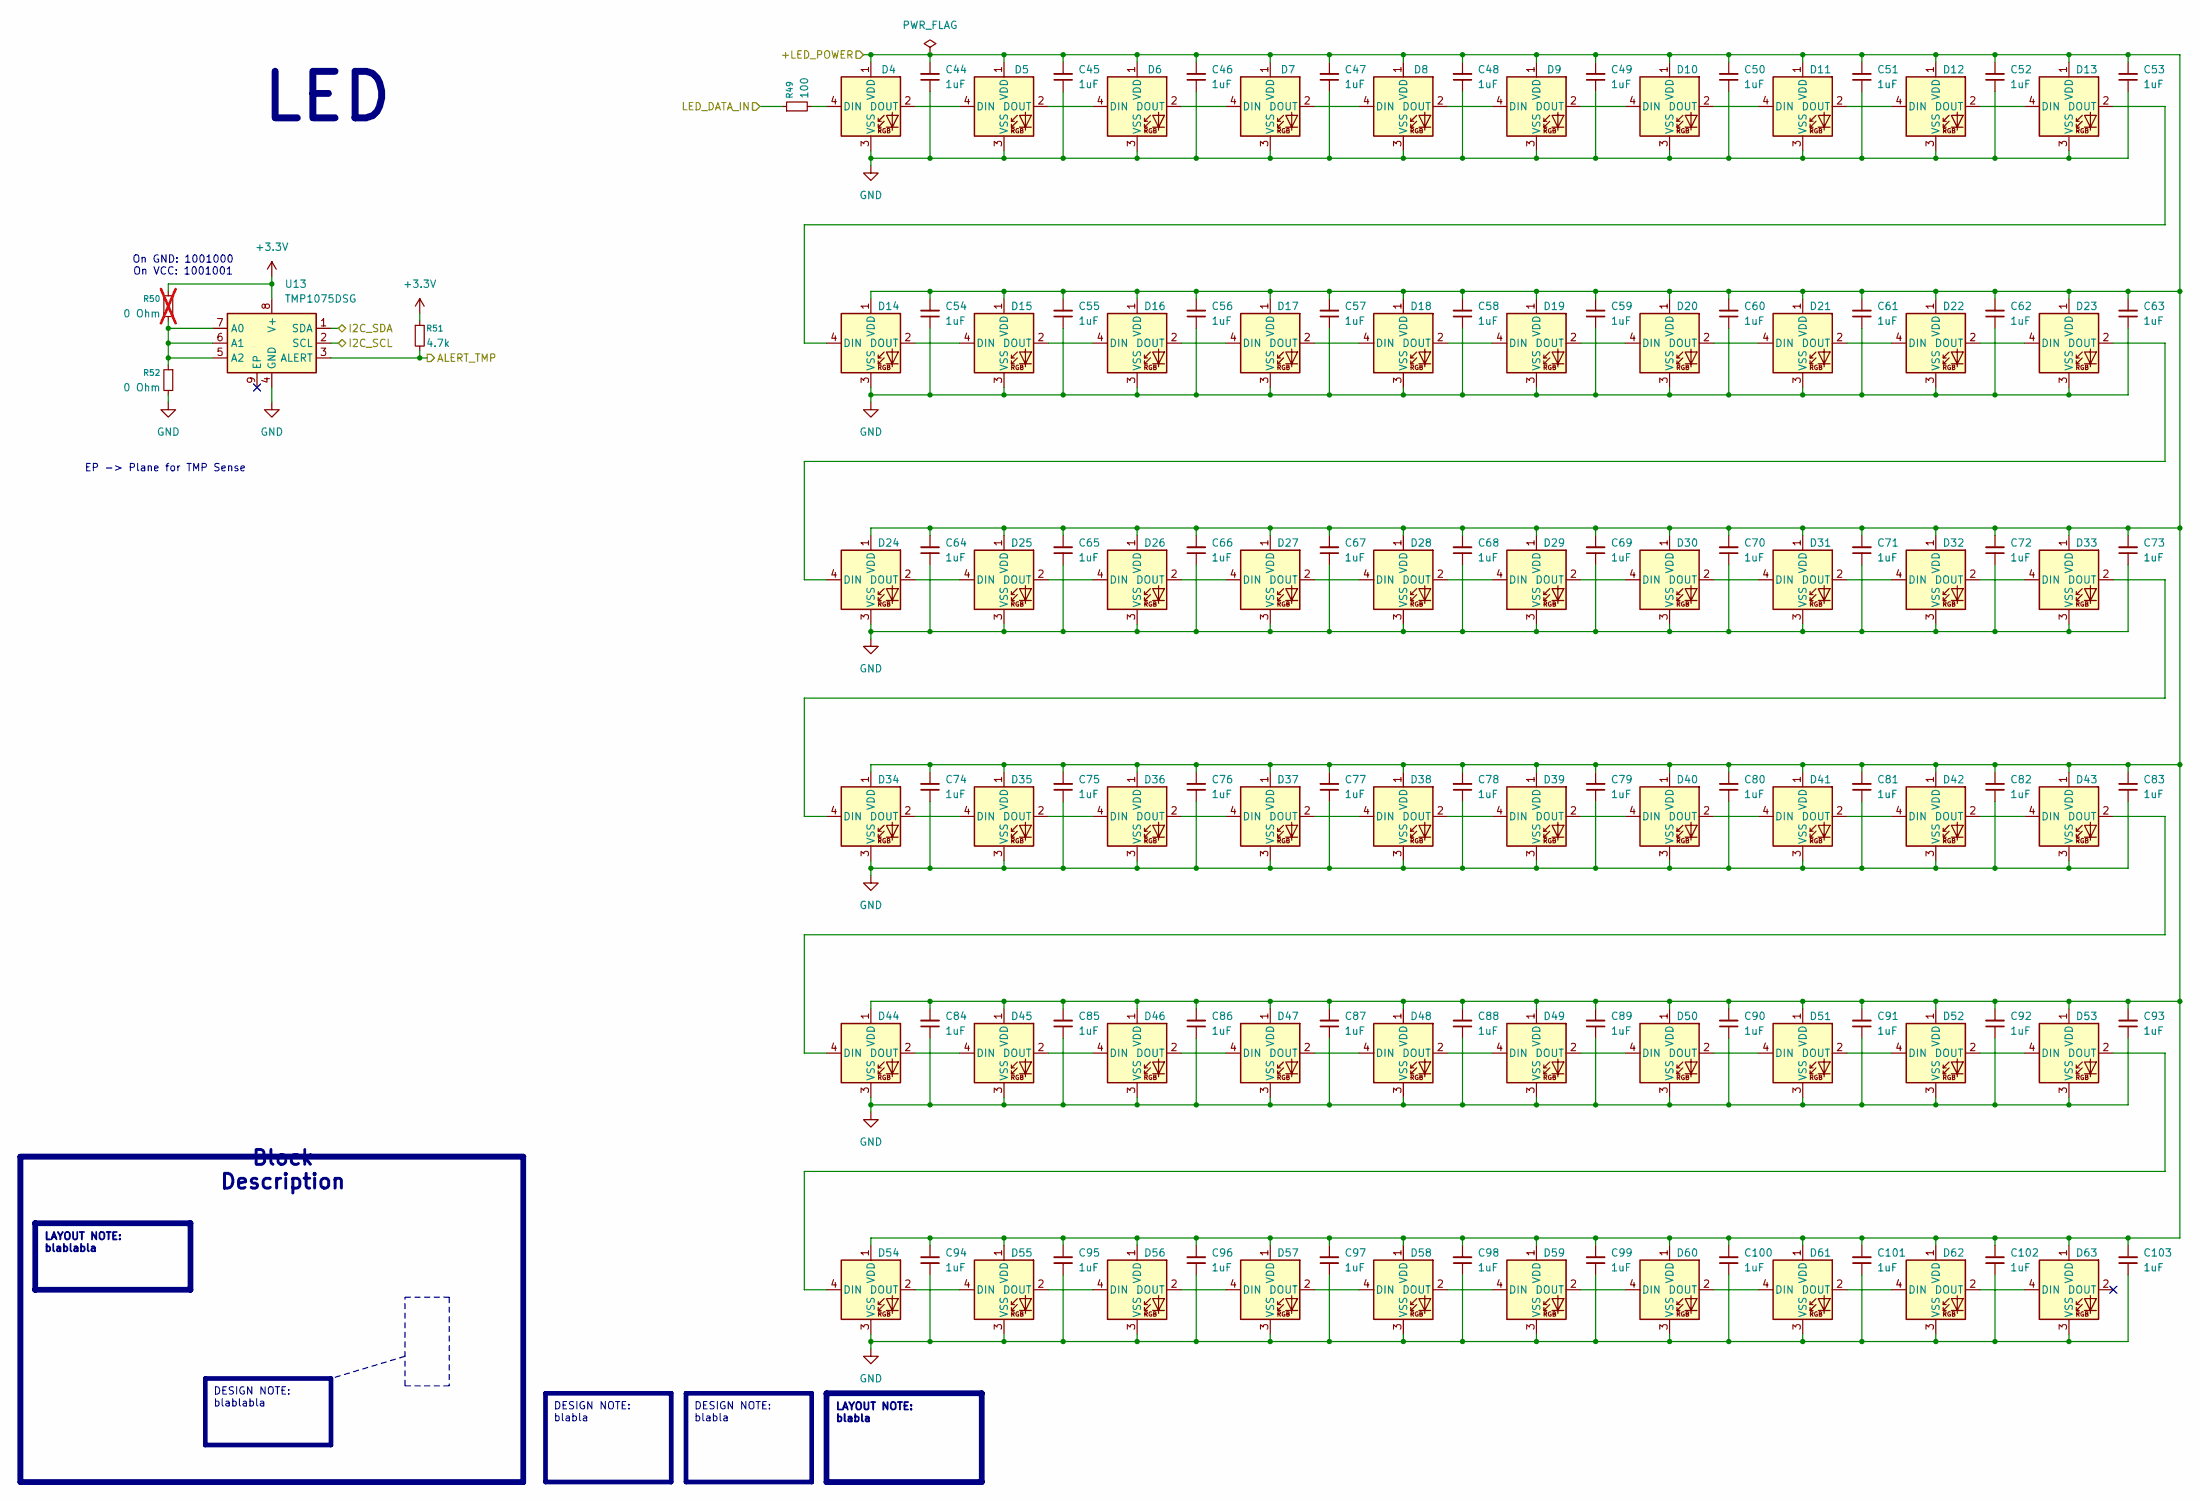
[picture p16: schematic LED.kicad_sch, Sheet Title A]

Parts:
C44, C45, C46, C47, C48, C49, C50, C51, C52, C53, C54, C55, C56, C57, C58, C59, C60, C61, C62, C63, C64, C65, C66, C67, C68, C69, C70, C71, C72, C73, C74, C75, C76, C77, C78, C79, C80, C81, C82, C83, C84, C85, C86, C87, C88, C89, C90, C91, C92, C93, C94, C95, C96, C97, C98, C99, C100, C101, C102, C103: 1uF; C_0603_1608Metric; LCSC Part # C15849
D4, D5, D6, D7, D8, D9, D10, D11, D12, D13, D14, D15, D16, D17, D18, D19, D20, D21, D22, D23, D24, D25, D26, D27, D28, D29, D30, D31, D32, D33, D34, D35, D36, D37, D38, D39, D40, D41, D42, D43, D44, D45, D46, D47, D48, D49, D50, D51, D52, D53, D54, D55, D56, D57, D58, D59, D60, D61, D62, D63: WS2812B; LED_WS2812B_PLCC4_5.0x5.0mm_P3.2mm; LCSC Part # C114587
R49: 100; R_0603_1608Metric; LCSC Part # C22775
R50: 0 Ohm; R_0603_1608Metric; not fitted
R51: 4.7k; R_0603_1608Metric; LCSC Part # C23162
R52: 0 Ohm; R_0603_1608Metric; LCSC Part # C21189
U13: TMP1075DSG; WSON-8-1EP_2x2mm_P0.5mm_EP0.9x1.6mm; LCSC Part # C2870250

Connections:
+3.3V: R50.1, R51.1, U13.8 (V+); also elsewhere on the board
+5V: C44.2, C45.2, C46.2, C47.2, C48.2, C49.2, C50.2, C51.2, C52.2, C53.2, C54.2, C55.2, C56.2, C57.2, C58.2, C59.2, C60.2, C61.2, C62.2, C63.2, C64.2, C65.2, C66.2, C67.2, C68.2, C69.2, C70.2, C71.2, C72.2, C73.2, C74.2, C75.2, C76.2, C77.2, C78.2, C79.2, C80.2, C81.2, C82.2, C83.2, C84.2, C85.2, C86.2, C87.2, C88.2, C89.2, C90.2, C91.2, C92.2, C93.2, C94.2, C95.2, C96.2, C97.2, C98.2, C99.2, C100.2, C101.2, C102.2, C103.2, D4.1 (VDD), D5.1 (VDD), D6.1 (VDD), D7.1 (VDD), D8.1 (VDD), D9.1 (VDD), D10.1 (VDD), D11.1 (VDD), D12.1 (VDD), D13.1 (VDD), D14.1 (VDD), D15.1 (VDD), D16.1 (VDD), D17.1 (VDD), D18.1 (VDD), D19.1 (VDD), D20.1 (VDD), D21.1 (VDD), D22.1 (VDD), D23.1 (VDD), D24.1 (VDD), D25.1 (VDD), D26.1 (VDD), D27.1 (VDD), D28.1 (VDD), D29.1 (VDD), D30.1 (VDD), D31.1 (VDD), D32.1 (VDD), D33.1 (VDD), D34.1 (VDD), D35.1 (VDD), D36.1 (VDD), D37.1 (VDD), D38.1 (VDD), D39.1 (VDD), D40.1 (VDD), D41.1 (VDD), D42.1 (VDD), D43.1 (VDD), D44.1 (VDD), D45.1 (VDD), D46.1 (VDD), D47.1 (VDD), D48.1 (VDD), D49.1 (VDD), D50.1 (VDD), D51.1 (VDD), D52.1 (VDD), D53.1 (VDD), D54.1 (VDD), D55.1 (VDD), D56.1 (VDD), D57.1 (VDD), D58.1 (VDD), D59.1 (VDD), D60.1 (VDD), D61.1 (VDD), D62.1 (VDD), D63.1 (VDD); also elsewhere on the board
/Project Architecture/LED/ALERT_TMP: R51.2, U13.3 (ALERT); also elsewhere on the board
/Project Architecture/LED/I2C_SCL: U13.2 (SCL); also elsewhere on the board
/Project Architecture/LED/I2C_SDA: U13.1 (SDA); also elsewhere on the board
/Project Architecture/LED/LED_DATA_IN: R49.1; also elsewhere on the board
GND: C44.1, C45.1, C46.1, C47.1, C48.1, C49.1, C50.1, C51.1, C52.1, C53.1, C54.1, C55.1, C56.1, C57.1, C58.1, C59.1, C60.1, C61.1, C62.1, C63.1, C64.1, C65.1, C66.1, C67.1, C68.1, C69.1, C70.1, C71.1, C72.1, C73.1, C74.1, C75.1, C76.1, C77.1, C78.1, C79.1, C80.1, C81.1, C82.1, C83.1, C84.1, C85.1, C86.1, C87.1, C88.1, C89.1, C90.1, C91.1, C92.1, C93.1, C94.1, C95.1, C96.1, C97.1, C98.1, C99.1, C100.1, C101.1, C102.1, C103.1, D4.3 (VSS), D5.3 (VSS), D6.3 (VSS), D7.3 (VSS), D8.3 (VSS), D9.3 (VSS), D10.3 (VSS), D11.3 (VSS), D12.3 (VSS), D13.3 (VSS), D14.3 (VSS), D15.3 (VSS), D16.3 (VSS), D17.3 (VSS), D18.3 (VSS), D19.3 (VSS), D20.3 (VSS), D21.3 (VSS), D22.3 (VSS), D23.3 (VSS), D24.3 (VSS), D25.3 (VSS), D26.3 (VSS), D27.3 (VSS), D28.3 (VSS), D29.3 (VSS), D30.3 (VSS), D31.3 (VSS), D32.3 (VSS), D33.3 (VSS), D34.3 (VSS), D35.3 (VSS), D36.3 (VSS), D37.3 (VSS), D38.3 (VSS), D39.3 (VSS), D40.3 (VSS), D41.3 (VSS), D42.3 (VSS), D43.3 (VSS), D44.3 (VSS), D45.3 (VSS), D46.3 (VSS), D47.3 (VSS), D48.3 (VSS), D49.3 (VSS), D50.3 (VSS), D51.3 (VSS), D52.3 (VSS), D53.3 (VSS), D54.3 (VSS), D55.3 (VSS), D56.3 (VSS), D57.3 (VSS), D58.3 (VSS), D59.3 (VSS), D60.3 (VSS), D61.3 (VSS), D62.3 (VSS), D63.3 (VSS), R52.2, U13.4 (GND); also elsewhere on the board
unnamed: D4.4 (DIN), R49.2
unnamed: D4.2 (DOUT), D5.4 (DIN)
unnamed: D5.2 (DOUT), D6.4 (DIN)
unnamed: D6.2 (DOUT), D7.4 (DIN)
unnamed: D7.2 (DOUT), D8.4 (DIN)
unnamed: D8.2 (DOUT), D9.4 (DIN)
unnamed: D9.2 (DOUT), D10.4 (DIN)
unnamed: D10.2 (DOUT), D11.4 (DIN)
unnamed: D11.2 (DOUT), D12.4 (DIN)
unnamed: D12.2 (DOUT), D13.4 (DIN)
unnamed: D13.2 (DOUT), D14.4 (DIN)
unnamed: D14.2 (DOUT), D15.4 (DIN)
unnamed: D15.2 (DOUT), D16.4 (DIN)
unnamed: D16.2 (DOUT), D17.4 (DIN)
unnamed: D17.2 (DOUT), D18.4 (DIN)
unnamed: D18.2 (DOUT), D19.4 (DIN)
unnamed: D19.2 (DOUT), D20.4 (DIN)
unnamed: D20.2 (DOUT), D21.4 (DIN)
unnamed: D21.2 (DOUT), D22.4 (DIN)
unnamed: D22.2 (DOUT), D23.4 (DIN)
unnamed: D23.2 (DOUT), D24.4 (DIN)
unnamed: D24.2 (DOUT), D25.4 (DIN)
unnamed: D25.2 (DOUT), D26.4 (DIN)
unnamed: D26.2 (DOUT), D27.4 (DIN)
unnamed: D27.2 (DOUT), D28.4 (DIN)
unnamed: D28.2 (DOUT), D29.4 (DIN)
unnamed: D29.2 (DOUT), D30.4 (DIN)
unnamed: D30.2 (DOUT), D31.4 (DIN)
unnamed: D31.2 (DOUT), D32.4 (DIN)
unnamed: D32.2 (DOUT), D33.4 (DIN)
unnamed: D33.2 (DOUT), D34.4 (DIN)
unnamed: D34.2 (DOUT), D35.4 (DIN)
unnamed: D35.2 (DOUT), D36.4 (DIN)
unnamed: D36.2 (DOUT), D37.4 (DIN)
unnamed: D37.2 (DOUT), D38.4 (DIN)
unnamed: D38.2 (DOUT), D39.4 (DIN)
unnamed: D39.2 (DOUT), D40.4 (DIN)
unnamed: D40.2 (DOUT), D41.4 (DIN)
unnamed: D41.2 (DOUT), D42.4 (DIN)
unnamed: D42.2 (DOUT), D43.4 (DIN)
unnamed: D43.2 (DOUT), D44.4 (DIN)
unnamed: D44.2 (DOUT), D45.4 (DIN)
unnamed: D45.2 (DOUT), D46.4 (DIN)
unnamed: D46.2 (DOUT), D47.4 (DIN)
unnamed: D47.2 (DOUT), D48.4 (DIN)
unnamed: D48.2 (DOUT), D49.4 (DIN)
unnamed: D49.2 (DOUT), D50.4 (DIN)
unnamed: D50.2 (DOUT), D51.4 (DIN)
unnamed: D51.2 (DOUT), D52.4 (DIN)
unnamed: D52.2 (DOUT), D53.4 (DIN)
unnamed: D53.2 (DOUT), D54.4 (DIN)
unnamed: D54.2 (DOUT), D55.4 (DIN)
unnamed: D55.2 (DOUT), D56.4 (DIN)
unnamed: D56.2 (DOUT), D57.4 (DIN)
unnamed: D57.2 (DOUT), D58.4 (DIN)
unnamed: D58.2 (DOUT), D59.4 (DIN)
unnamed: D59.2 (DOUT), D60.4 (DIN)
unnamed: D60.2 (DOUT), D61.4 (DIN)
unnamed: D61.2 (DOUT), D62.4 (DIN)
unnamed: D62.2 (DOUT), D63.4 (DIN)
unnamed: R50.2, R52.1, U13.5 (A2), U13.6 (A1), U13.7 (A0)

Notes on the sheet:
EP -> Plane for TMP Sense
On GND: 1001000 On VCC: 1001001
DESIGN NOTE: blabla
LAYOUT NOTE: blabla
DESIGN NOTE: blablabla
LED
LAYOUT NOTE: blablabla
Block Description

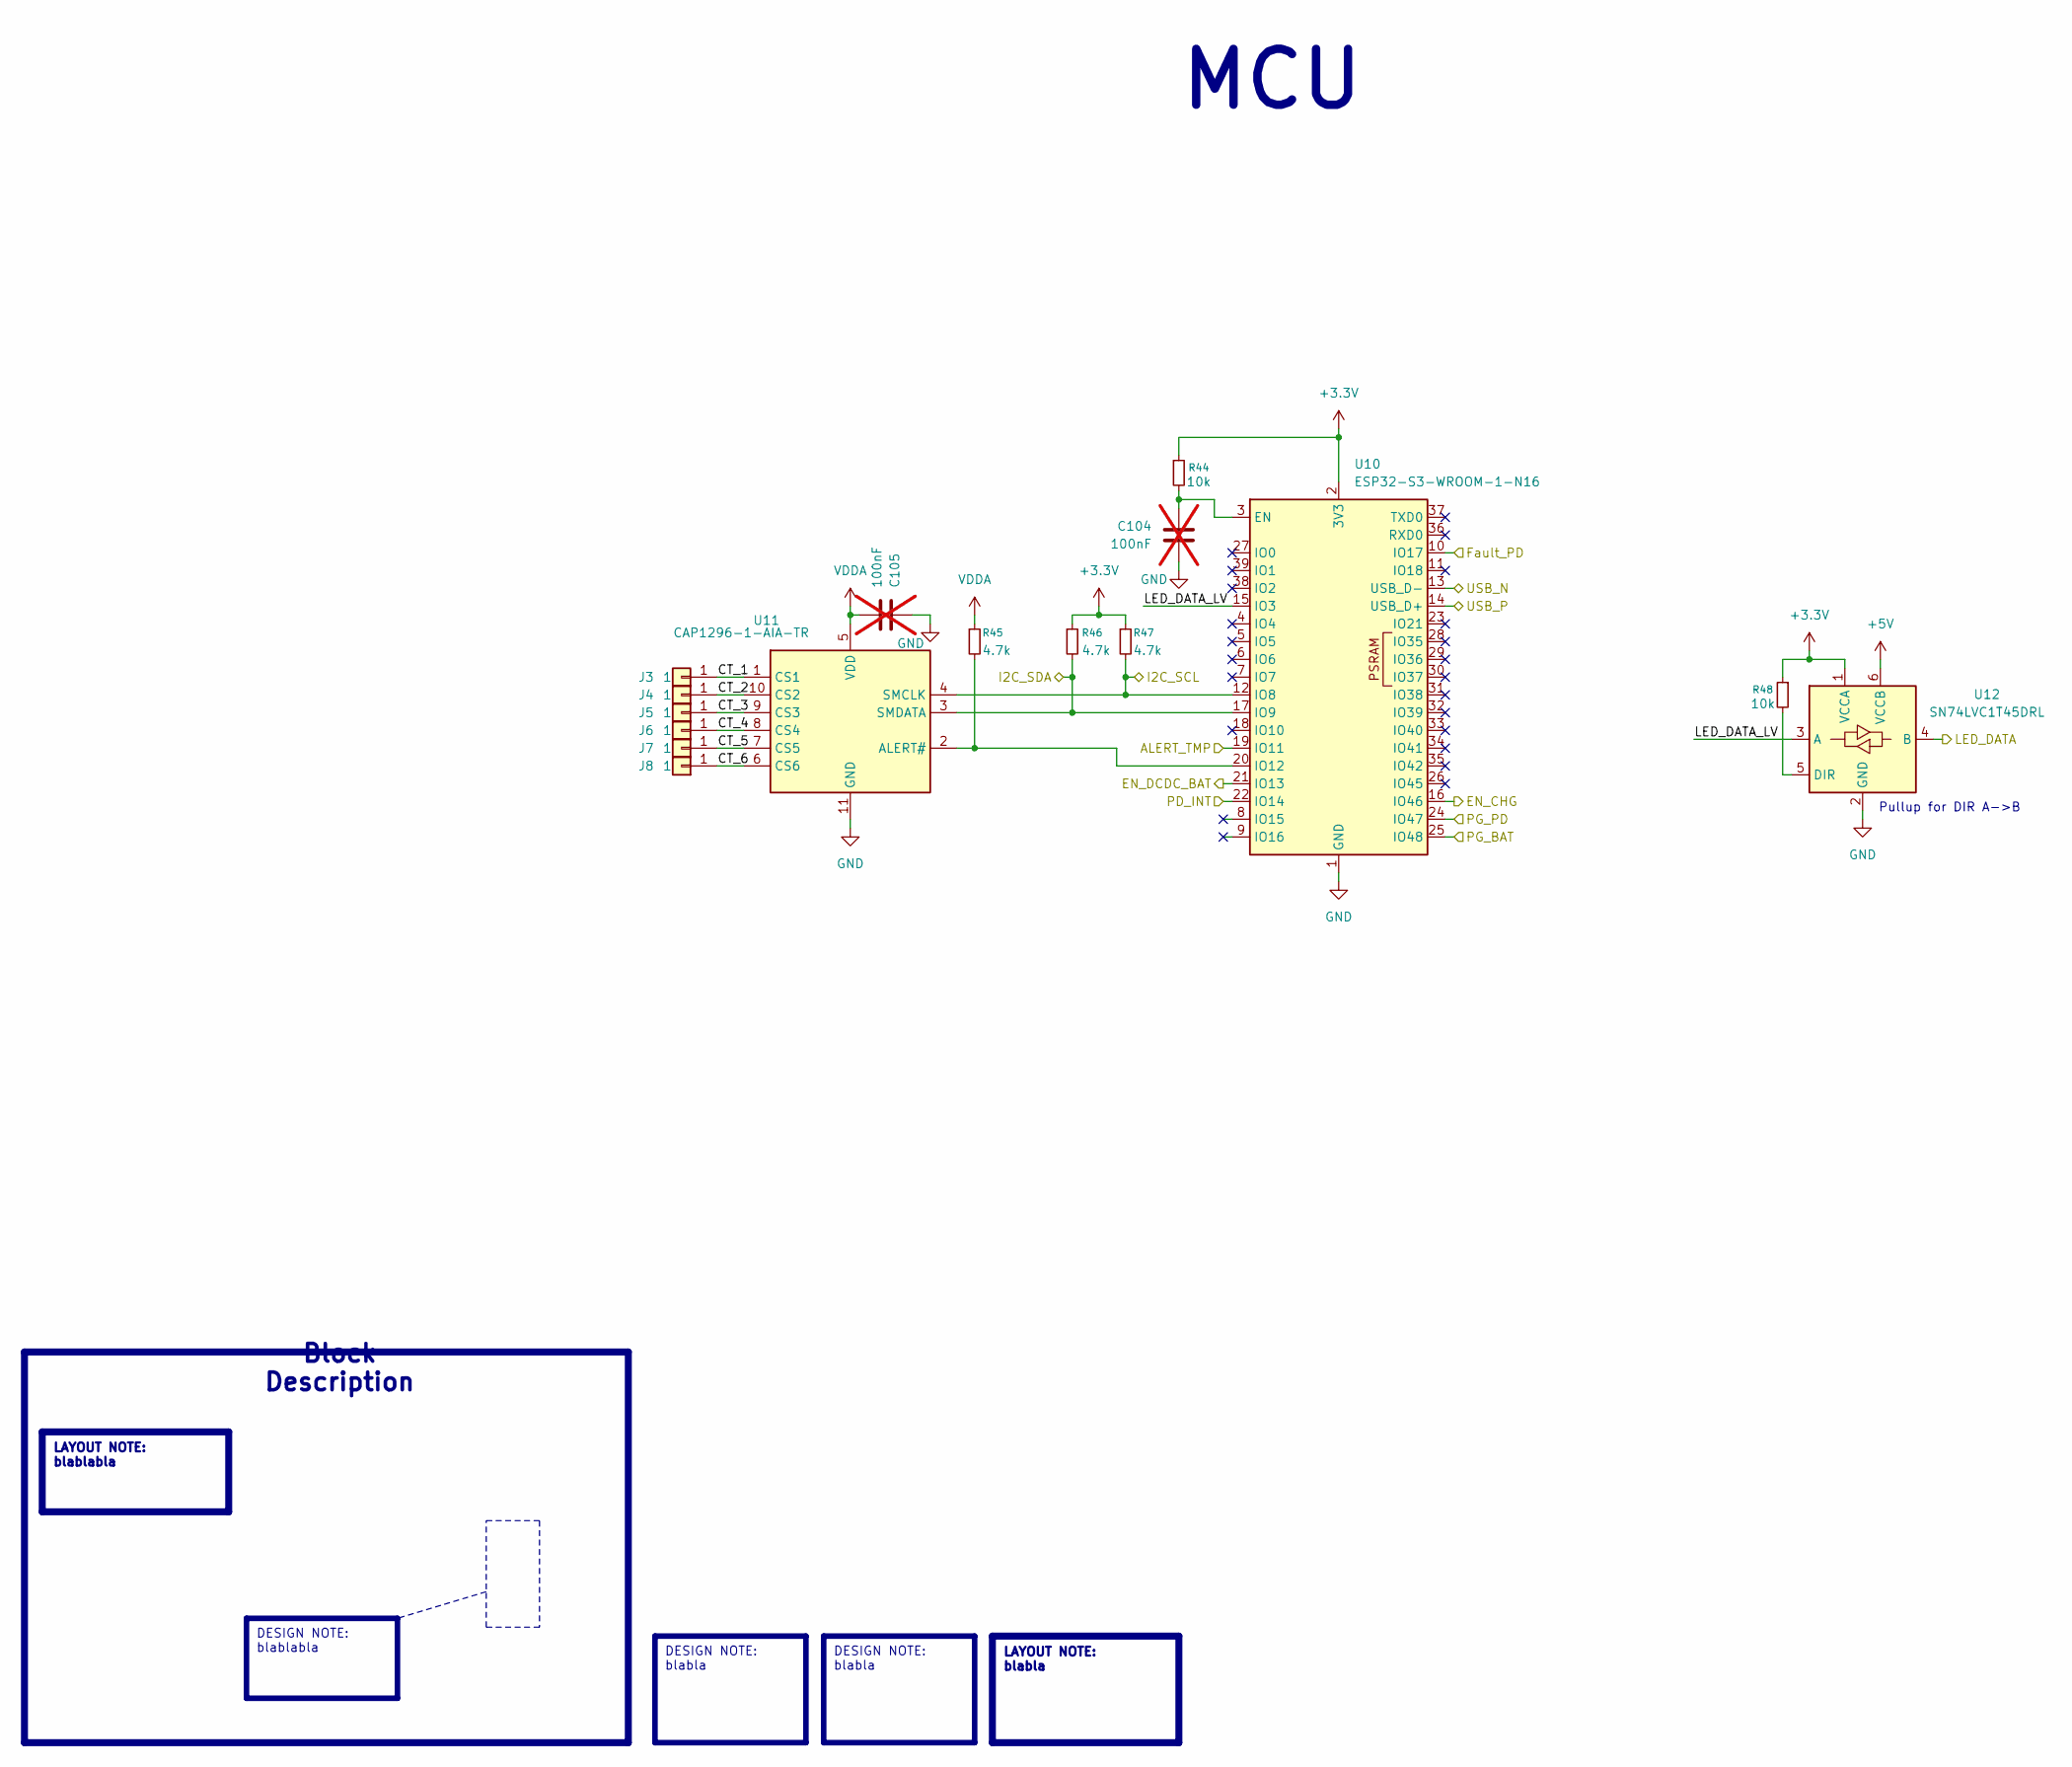
[picture p17: schematic MCU.kicad_sch, Sheet Title A]

Parts:
C104, C105: 100nF; C_0603_1608Metric; LCSC Part # C14663; not fitted
J3, J4, J5, J6, J7, J8: 1; JST_XH_B1B-XH-AM_1x01_P2.50mm_Vertical; LCSC Part # C20088533
R44, R48: 10k; R_0603_1608Metric; LCSC Part # C25804
R45, R46, R47: 4.7k; R_0603_1608Metric; LCSC Part # C23162
U10: ESP32-S3-WROOM-1-N16; ESP32-S3-WROOM-1; LCSC Part # C2913199
U11: CAP1296-1-AIA-TR; DFN-10-1EP_3x3mm_P0.5mm_EP1.55x2.48mm; LCSC Part # C2652051
U12: SN74LVC1T45DRL; SOT-563; LCSC Part # C352970

Connections:
+3.3V: R44.1, R46.1, R47.1, R48.1, U10.2 (3V3), U12.1 (VCCA); also elsewhere on the board
+5V: U12.6 (VCCB); also elsewhere on the board
/Project Architecture/Battery/EN_CHG: U10.16 (IO46); also elsewhere on the board
/Project Architecture/LED/ALERT_TMP: U10.19 (IO11); also elsewhere on the board
/Project Architecture/LED/I2C_SCL: R47.2, U10.12 (IO8), U11.4 (SMCLK); also elsewhere on the board
/Project Architecture/LED/I2C_SDA: R46.2, U10.17 (IO9), U11.3 (SMDATA); also elsewhere on the board
/Project Architecture/LED/LED_DATA_IN: U12.4 (B); also elsewhere on the board
/Project Architecture/MCU/CT_1: J3.1 (Pin_1_1), U11.1 (CS1)
/Project Architecture/MCU/CT_2: J4.1 (Pin_1_1), U11.10 (CS2)
/Project Architecture/MCU/CT_3: J5.1 (Pin_1_1), U11.9 (CS3)
/Project Architecture/MCU/CT_4: J6.1 (Pin_1_1), U11.8 (CS4)
/Project Architecture/MCU/CT_5: J7.1 (Pin_1_1), U11.7 (CS5)
/Project Architecture/MCU/CT_6: J8.1 (Pin_1_1), U11.6 (CS6)
/Project Architecture/MCU/EN_DCDC_BAT: U10.21 (IO13); also elsewhere on the board
/Project Architecture/MCU/Fault_PD: U10.10 (IO17); also elsewhere on the board
/Project Architecture/MCU/LED_DATA_LV: U10.15 (IO3), U12.3 (A)
/Project Architecture/MCU/PD_INT: U10.22 (IO14); also elsewhere on the board
/Project Architecture/MCU/PG_BAT: U10.25 (IO48); also elsewhere on the board
/Project Architecture/MCU/PG_PD: U10.24 (IO47); also elsewhere on the board
/Project Architecture/powerdelivery/USB_N: U10.13 (USB_D-); also elsewhere on the board
/Project Architecture/powerdelivery/USB_P: U10.14 (USB_D+); also elsewhere on the board
GND: C104.2, C105.1, U10.1 (GND), U10.40 (GND), U10.41 (GND), U11.11 (GND), U12.2 (GND); also elsewhere on the board
unnamed: C104.1, R44.2, U10.3 (EN)
unnamed: R45.2, U10.20 (IO12), U11.2 (ALERT#)
unnamed: R48.2, U12.5 (DIR)
VDDA: C105.2, R45.1, U11.5 (VDD); also elsewhere on the board

Notes on the sheet:
Pullup for DIR A->B
LAYOUT NOTE: blabla
DESIGN NOTE: blabla
Block Description
LAYOUT NOTE: blablabla
MCU
DESIGN NOTE: blablabla

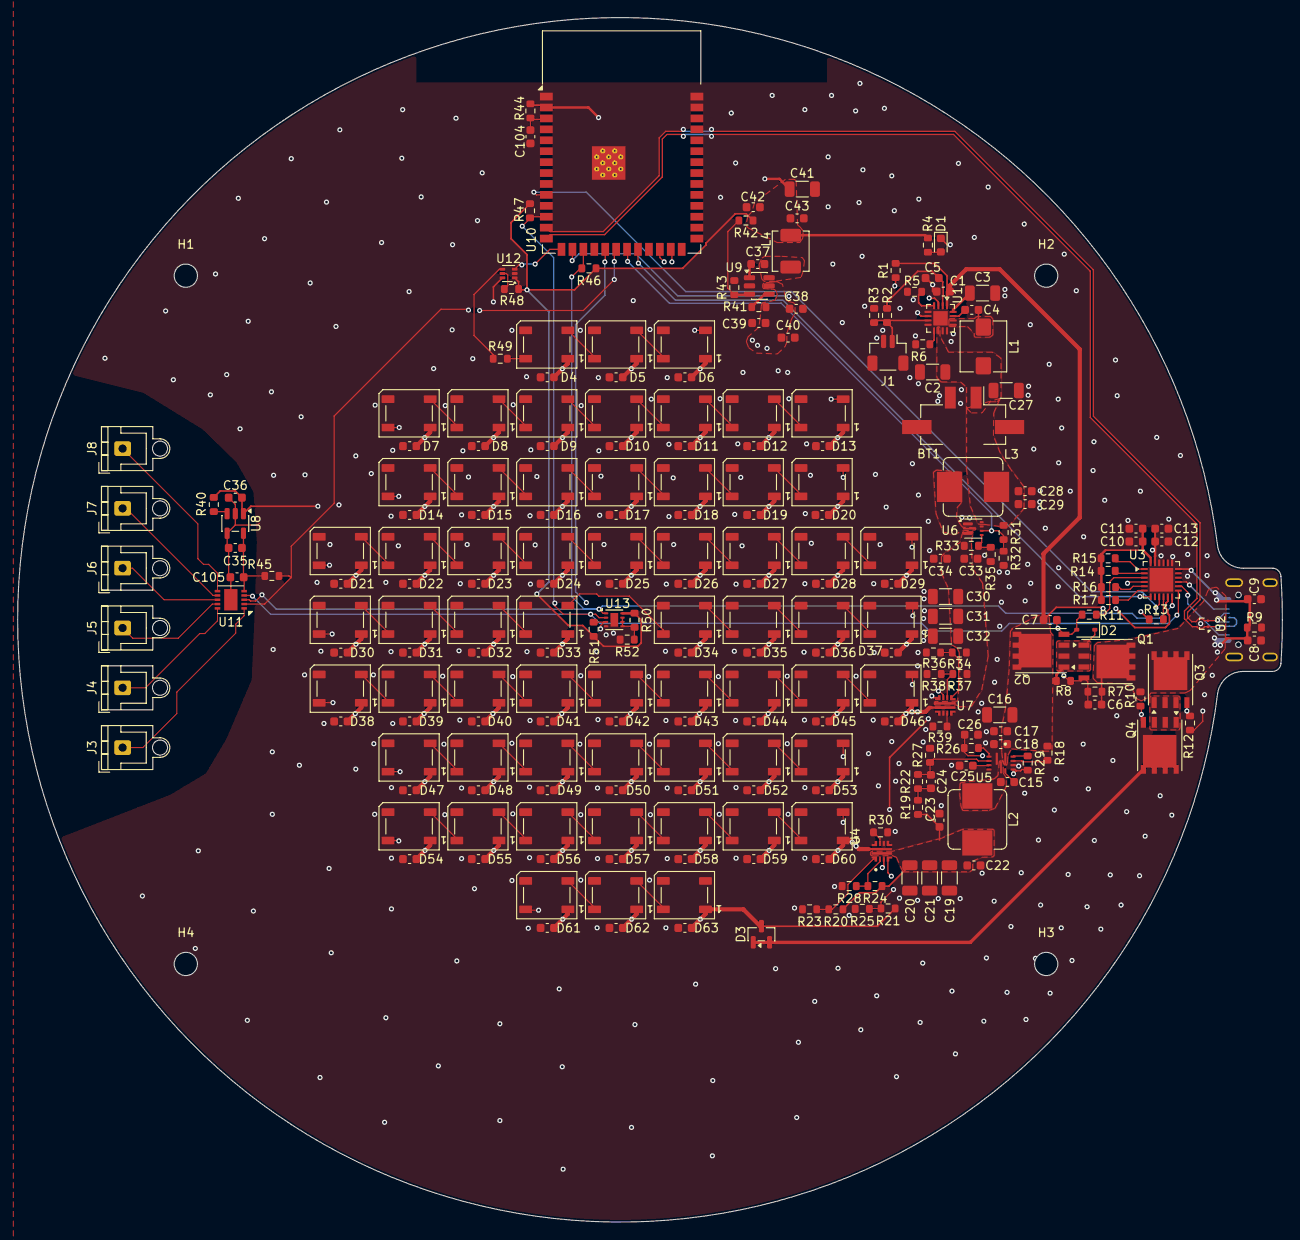
[picture p18: board PCB_v2.kicad_pcb from above]

Board: 6 copper layers, 147.0 x 140.0 mm, 253 parts (1 on the bottom side), 140 nets.
