DodoZimmermann/lamp-2/(commit log)

2026-01-28 first lamp model
    [LampBall.blend, LampBall.stl]
2026-01-28 lamp body with rim added thickness ~2mm, all files updated
    [LampBall.blend, LampBall.f3d, LampBall.stl]
2026-01-28 Folder Strucure made
    [LampBall.blend, LampBall.f3d, LampBall.stl]
2026-01-28 Schematic, PD and 3.3V DCDC
    [Microcontroller.kicad_sch, PCB.kicad_pcb, PCB.kicad_sch, Parts List.xlsx, battery.kicad_sch, leds.kicad_sch, power_systems.kicad_sch, usbc.kicad_sch]
2026-01-29 battery charger added
    [PCB.kicad_sch, Parts List.xlsx, battery.kicad_sch, leds.kicad_sch, power_systems.kicad_sch]
2026-03-09 project state at start of school project
    [BQ24600RVAR.step, PCB.kicad_sch, battery.kicad_sch, power_systems.kicad_sch, usbc.kicad_sch]
2026-03-13 Basic Schematic finished, external connectors missing, no footprints or LCSC numbers yet
    [LM73100RPWR.step, Microcontroller.kicad_sch, PCB.kicad_pcb, PCB.kicad_sch, TPS51385RJNR.step, battery.kicad_sch, leds.kicad_sch, power_systems.kicad_sch]
2026-04-02 layout v1 finished but not confirmed yet
    [Block Diagram.kicad_sch, LampBall.blend, LampBall.stl, LampBall_Gross.step, Microcontroller.kicad_sch, PCB.kicad_pcb, PCB.kicad_sch, PCB_Outline.dxf]
2026-04-14 pcb finished but jlcpcb toolkit not working
    [PCB-B_Cu.gbl, PCB-B_Mask.gbs, PCB-B_Paste.gbp, PCB-B_Silkscreen.gbo, PCB-Edge_Cuts.gm1, PCB-F_Cu.gtl, PCB-F_Mask.gts, PCB-F_Paste.gtp]
2026-04-21 manual LED circle done
    [Battery.kicad_sch, Block Diagram.kicad_sch, LED.kicad_sch, MCU.kicad_sch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]
2026-04-21 removed backup files in PCBv1
2026-04-24 Components placed
    [Battery.kicad_sch, LED.kicad_sch, MCU.kicad_sch, PCB_v2.kicad_pcb, Power.kicad_sch, bom.csv, designators.csv, positions.csv]
2026-04-24 PCB finished, export working
    [LED.kicad_sch, MCU.kicad_sch, PCB_v2.kicad_pcb, positions.csv, powerdelivery.kicad_sch]
2026-06-07 first Claude Software
    [Battery.kicad_sch, LED.kicad_sch, MCU.kicad_sch, PCB_v2.kicad_pcb, Parts List.xlsx, Power.kicad_sch, Project Architecture.kicad_sch, bom.csv]
2026-06-08 first fully working software, undervoltage not added yet
    [PCB_v2.kicad_sch, powerdelivery.kicad_sch]
